felipecacique/MagneticLevitation/Others/arduino com interface grafica utilizando processing.docx

Estive trabalhando hoje na interface gráfica do arduino utilizando o processing, e eis os resultados que obtive: as curvas são valores de tensão lidas na entrada analógica do arduino

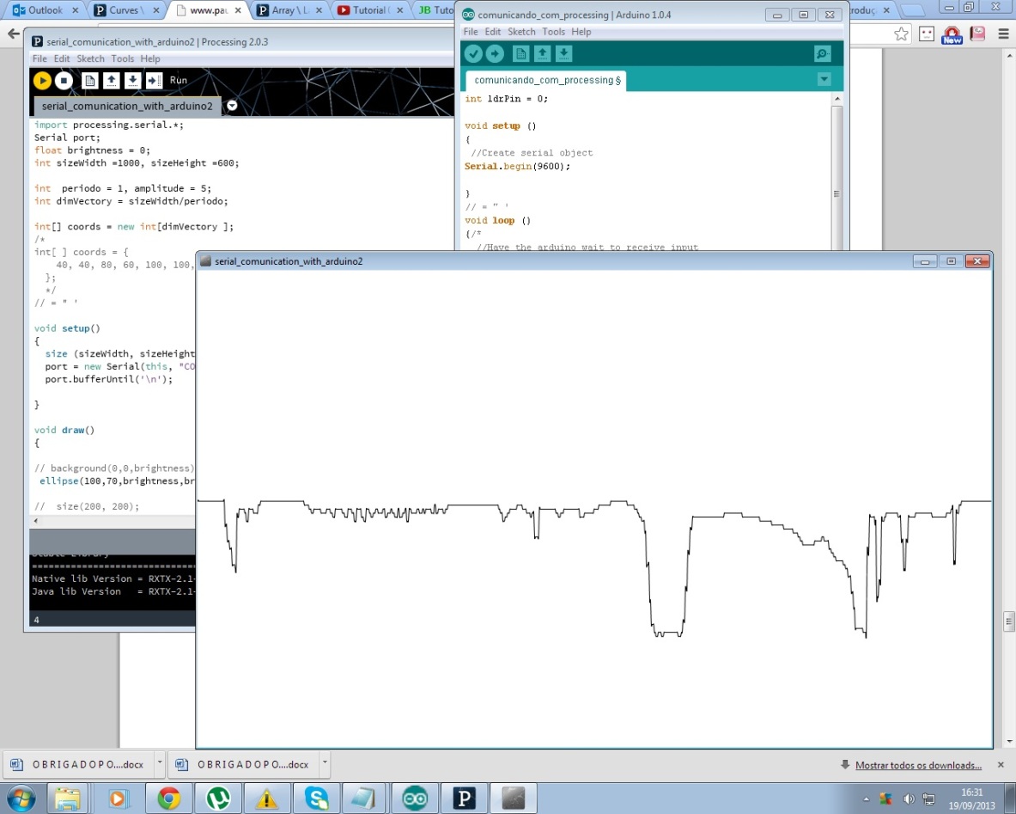
[picture p8: figure]
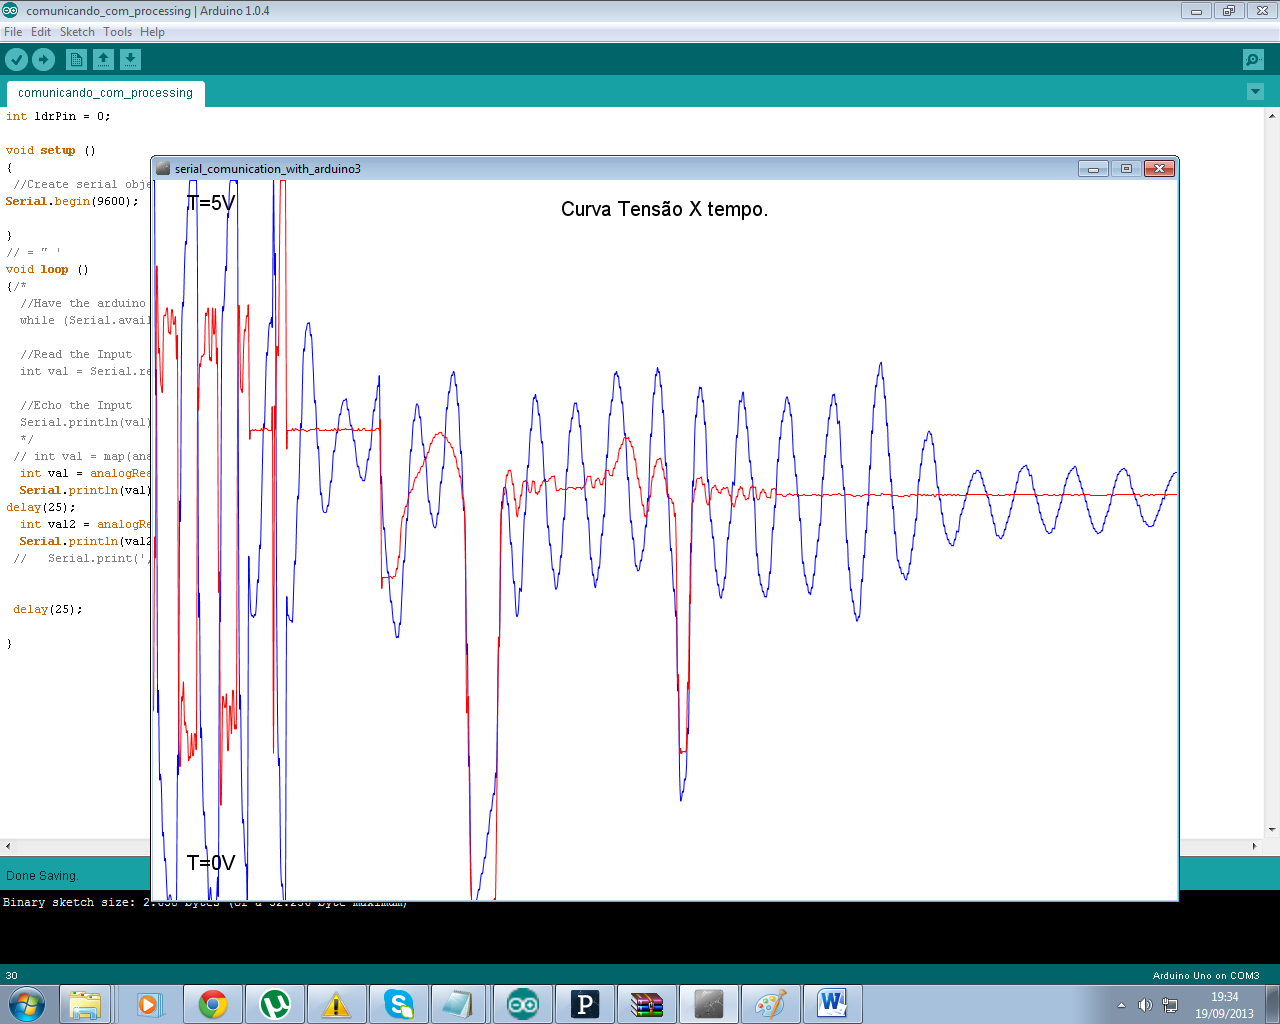
[picture p9: figure]

Leitura simultânea de duas entradas analogicas
