felipecacique/MagneticLevitation/Others/13.png

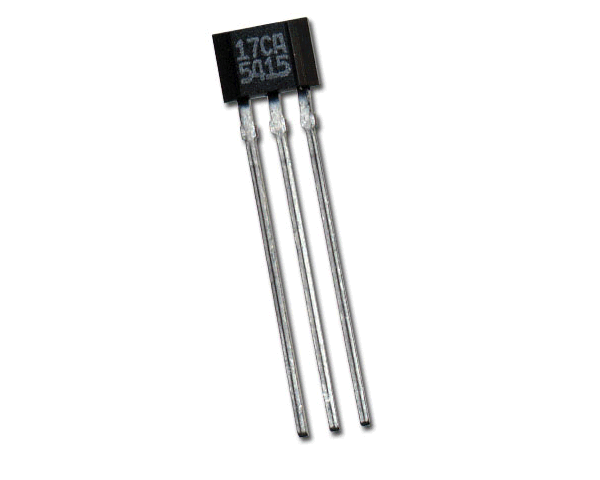
Others/13.png
