felipecacique/MagneticLevitation/Others/21.jpg

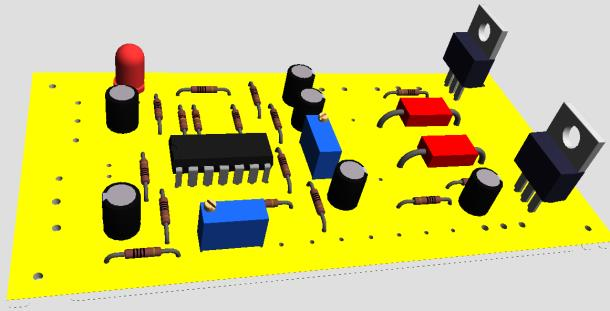
Others/21.jpg
