felipecacique/MagneticLevitation/Others/23.jpg

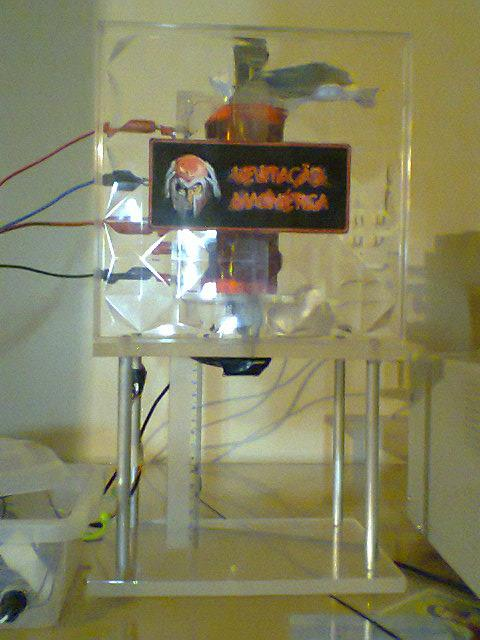
Others/23.jpg
