felipecacique/MagneticLevitation/Others/amplificando sinal com ao.jpg

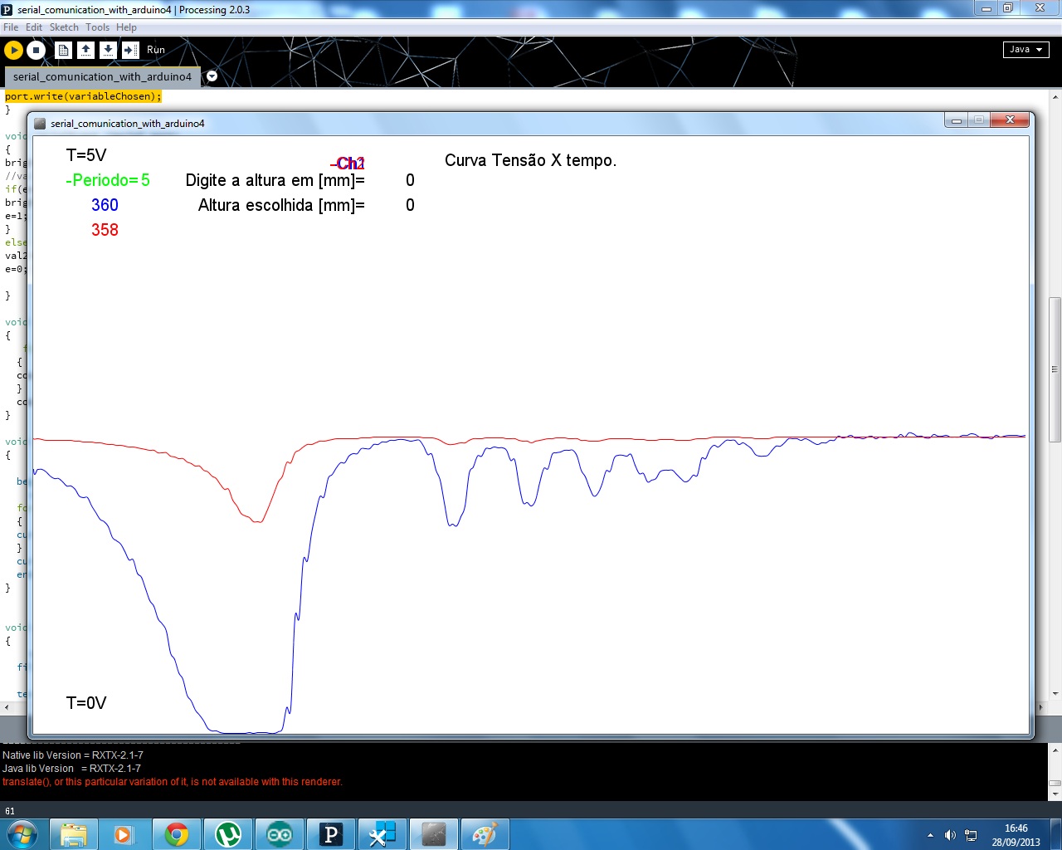
Others/amplificando sinal com ao.jpg
