felipecacique/MagneticLevitation/Others/ard mais process.png

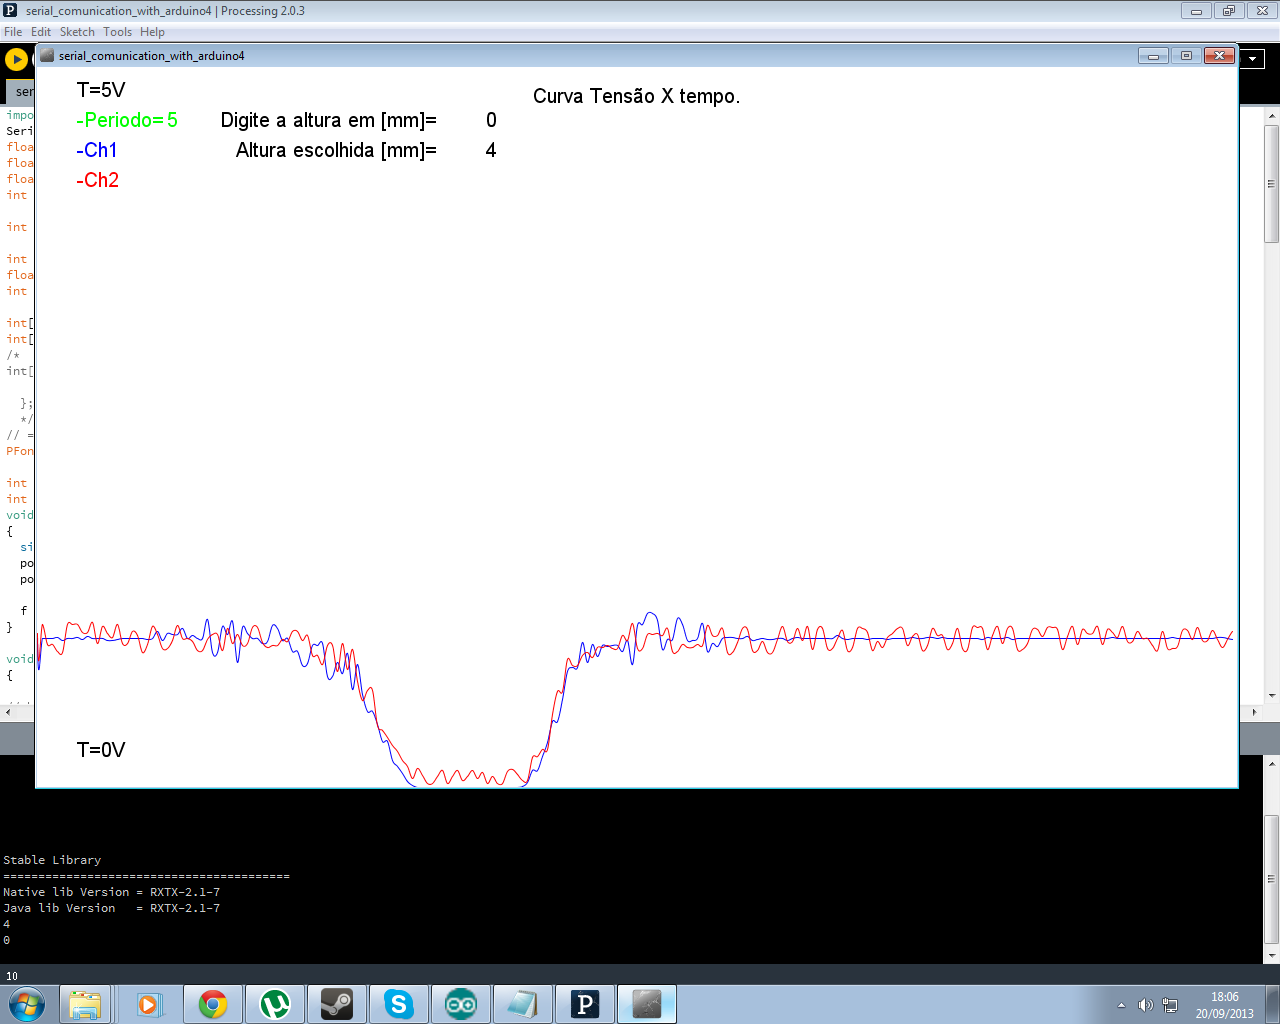
Others/ard mais process.png
