felipecacique/MagneticLevitation/Others/CONDICIONAMENTO DE SINAL.png

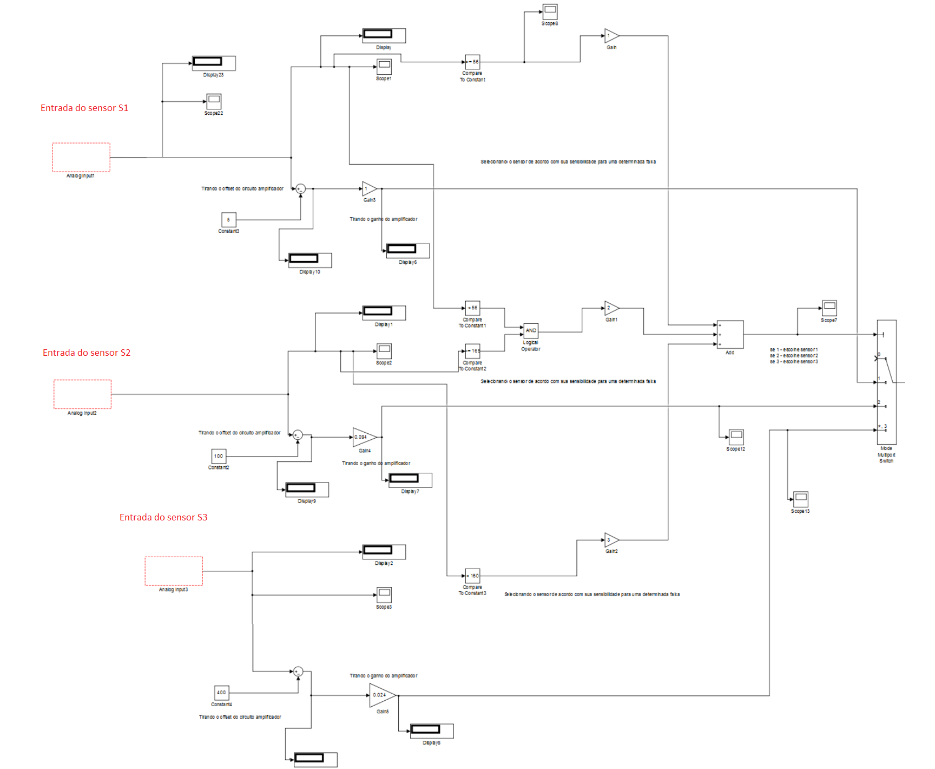
Others/CONDICIONAMENTO DE SINAL.png
