felipecacique/MagneticLevitation/Others/conversao do sensor em posicao.png

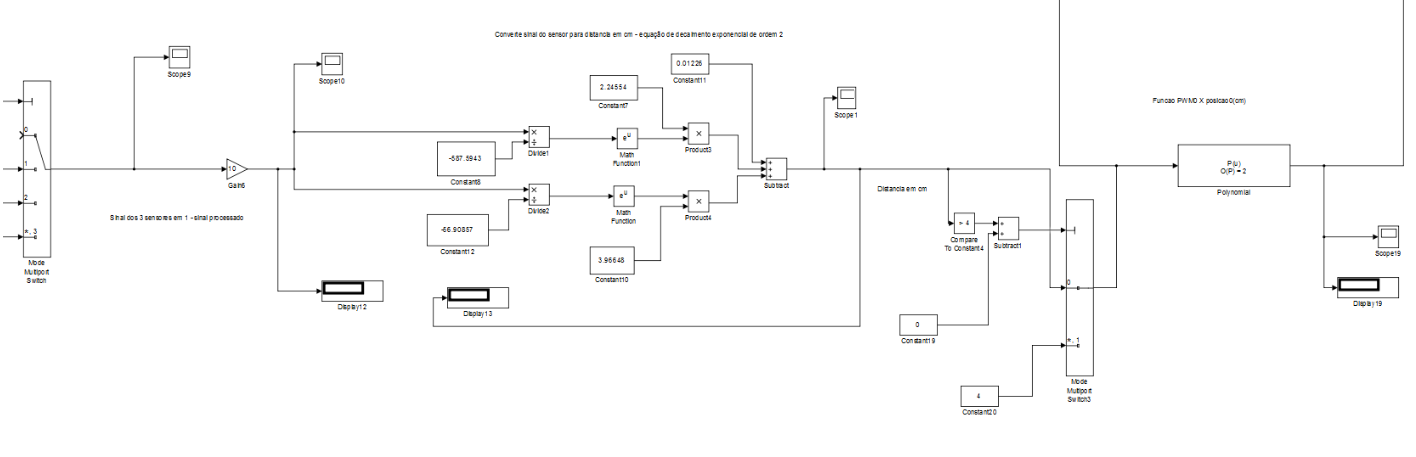
Others/conversao do sensor em posicao.png
