felipecacique/MagneticLevitation/Others/curva tensao x tempo real time.jpg

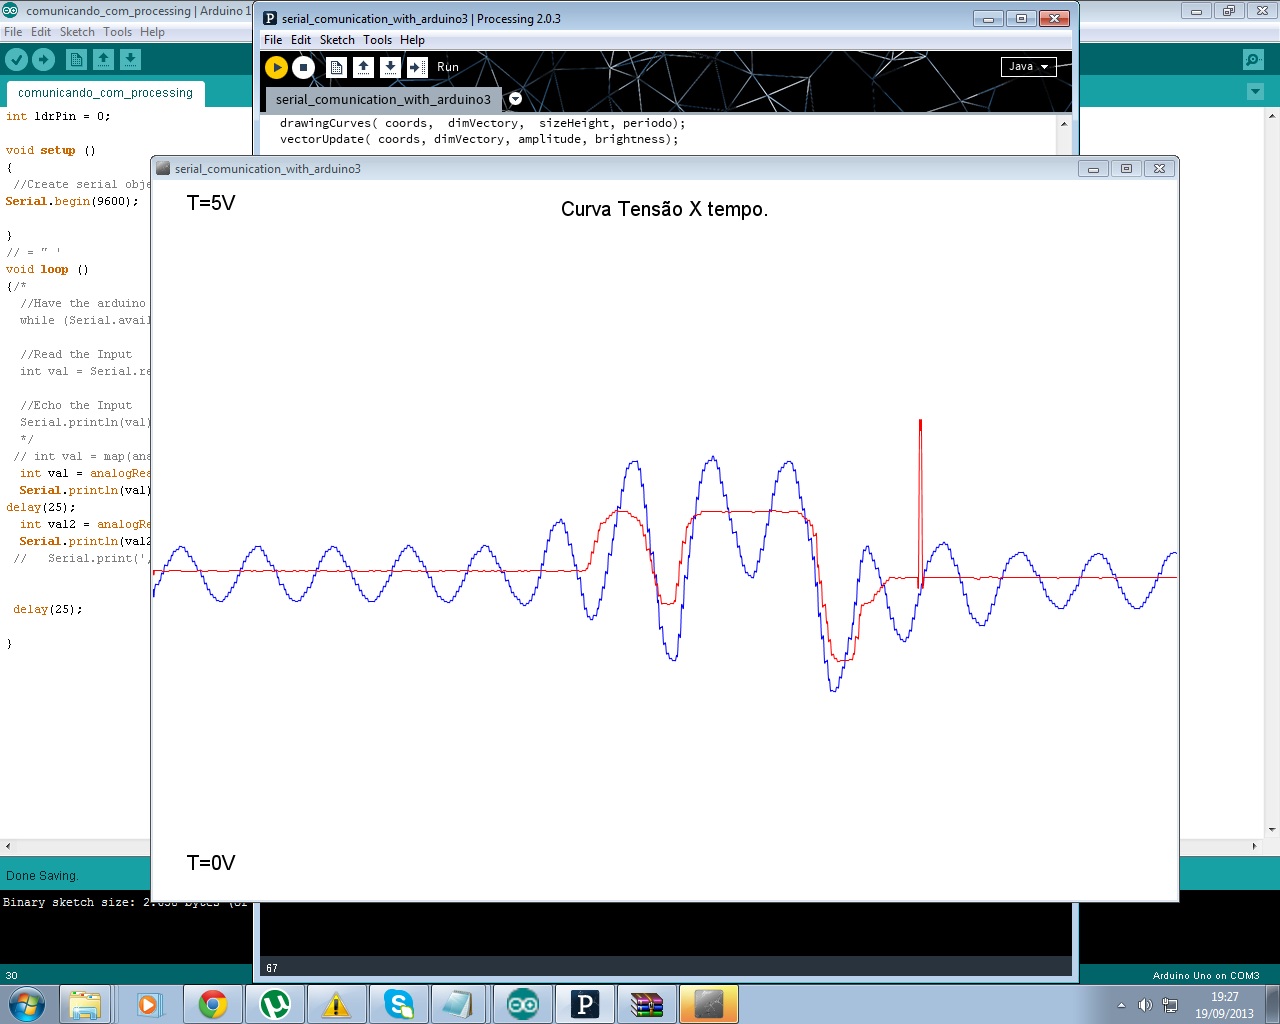
Others/curva tensao x tempo real time.jpg
