felipecacique/MagneticLevitation/Others/malha de controle.png

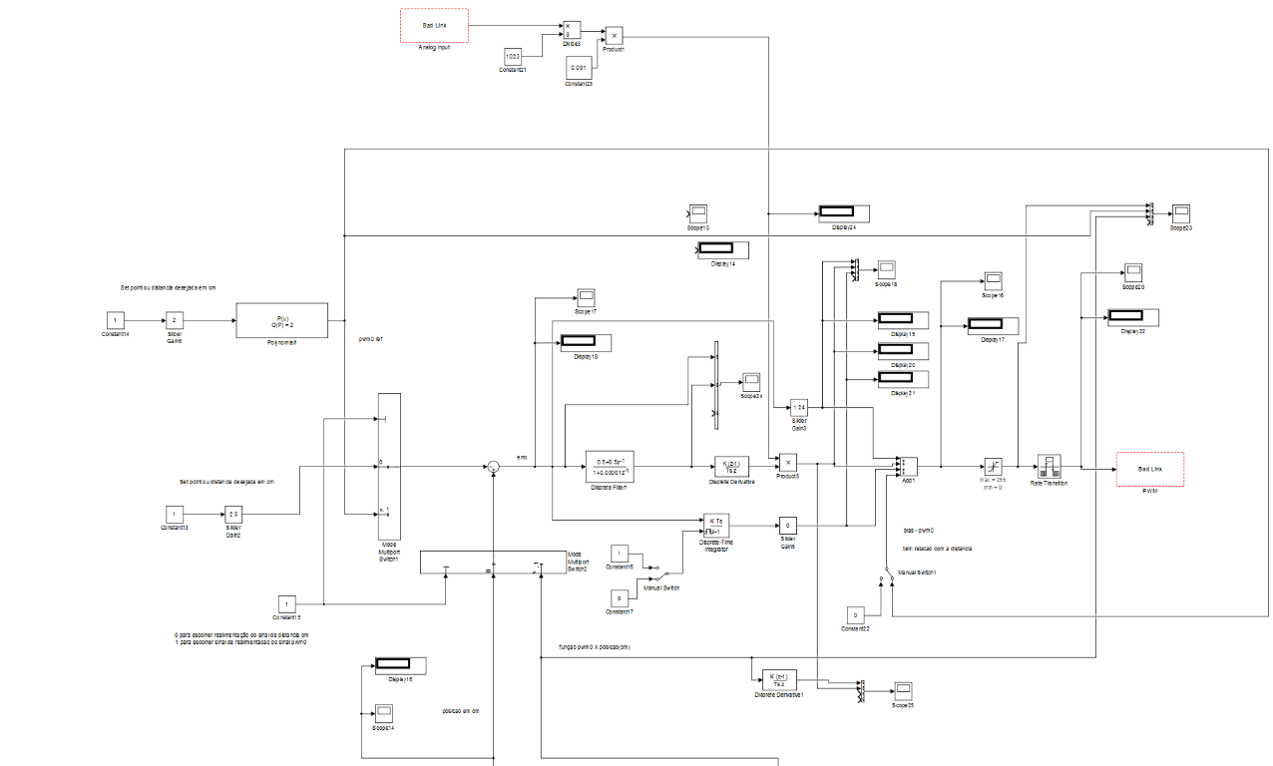
Others/malha de controle.png
