felipecacique/MagneticLevitation/Others/monragem1.JPG

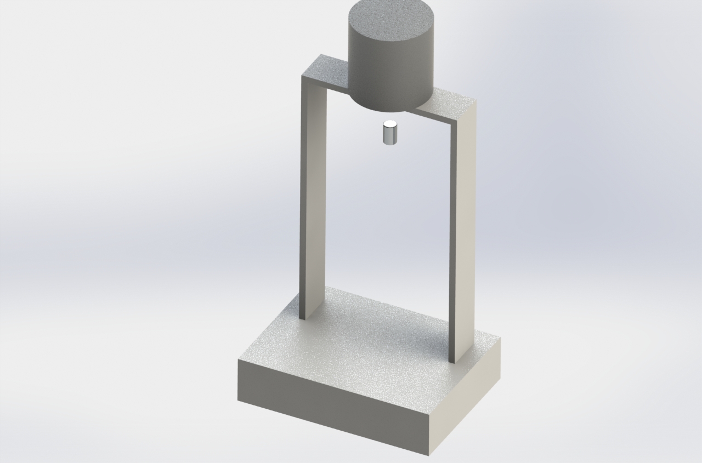
Others/monragem1.JPG
