felipecacique/MagneticLevitation/Others/pcb 3d.png

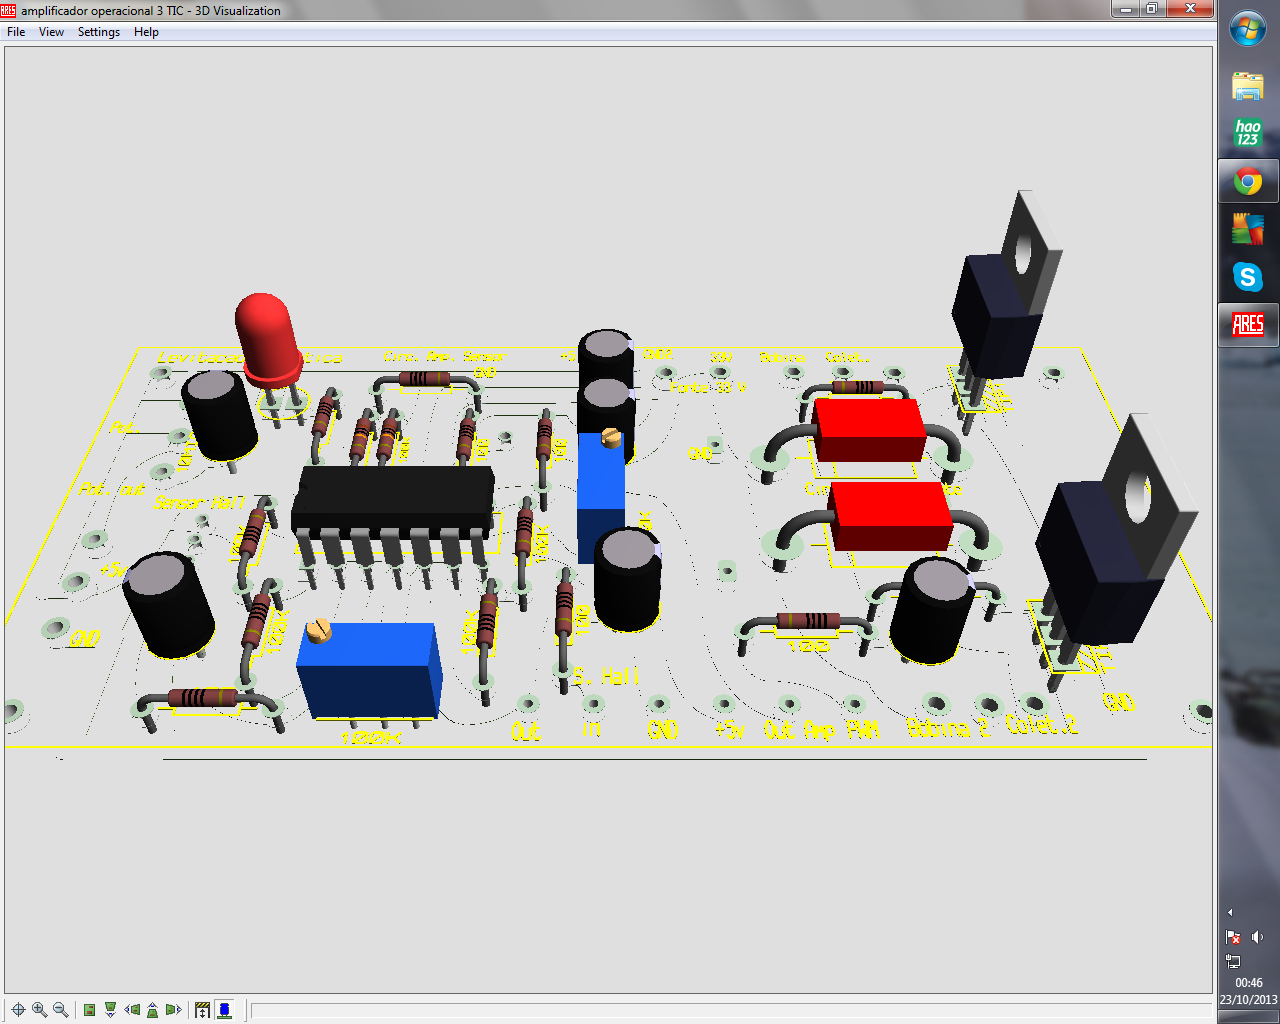
Others/pcb 3d.png
