felipecacique/MagneticLevitation/Others/pcb.png

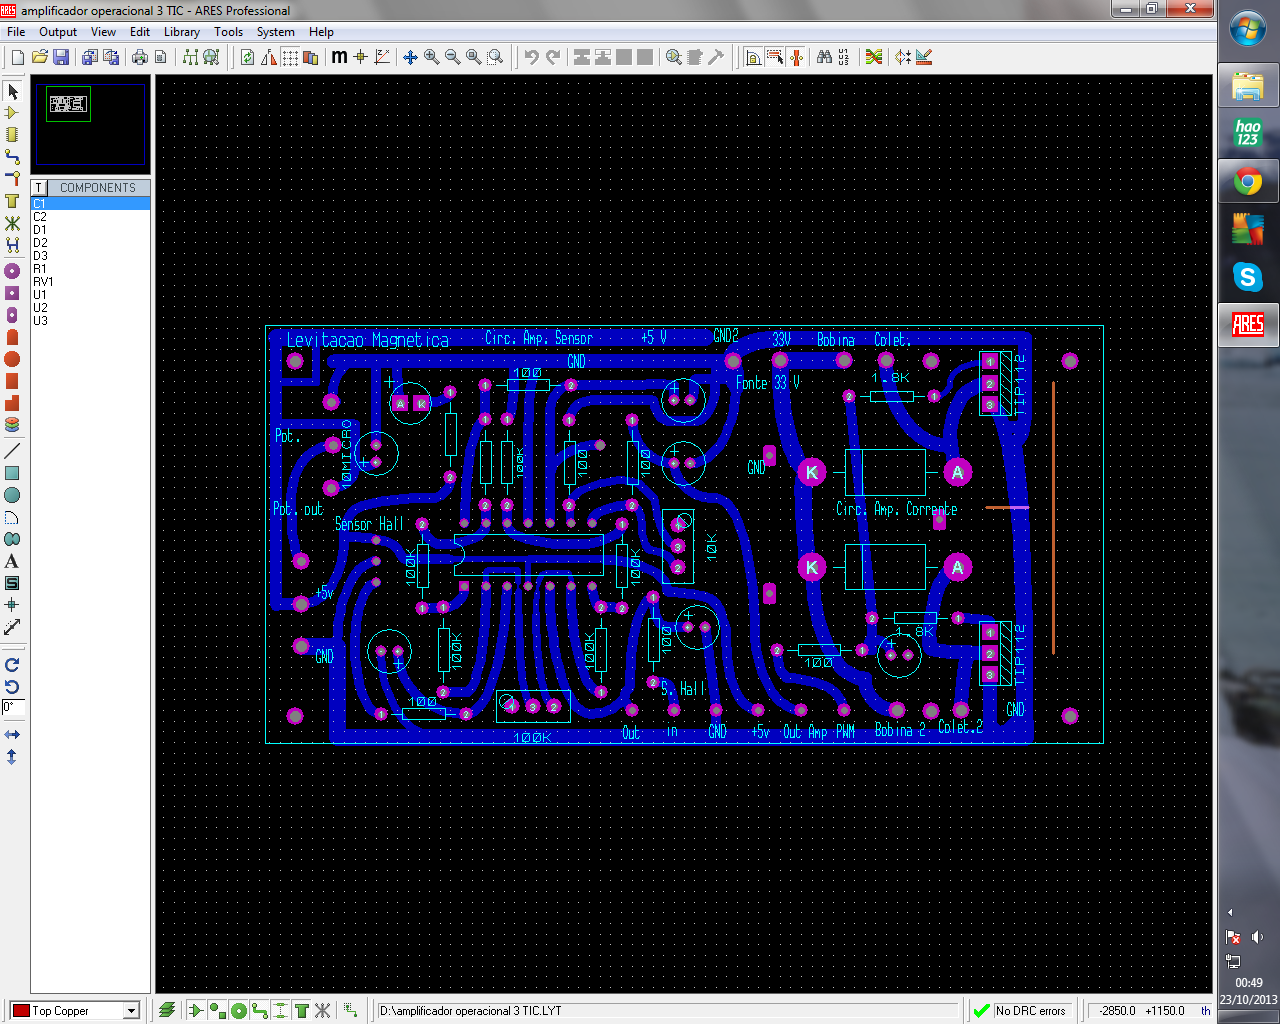
Others/pcb.png
