felipecacique/MagneticLevitation/Others/posiçaoxsensor.png

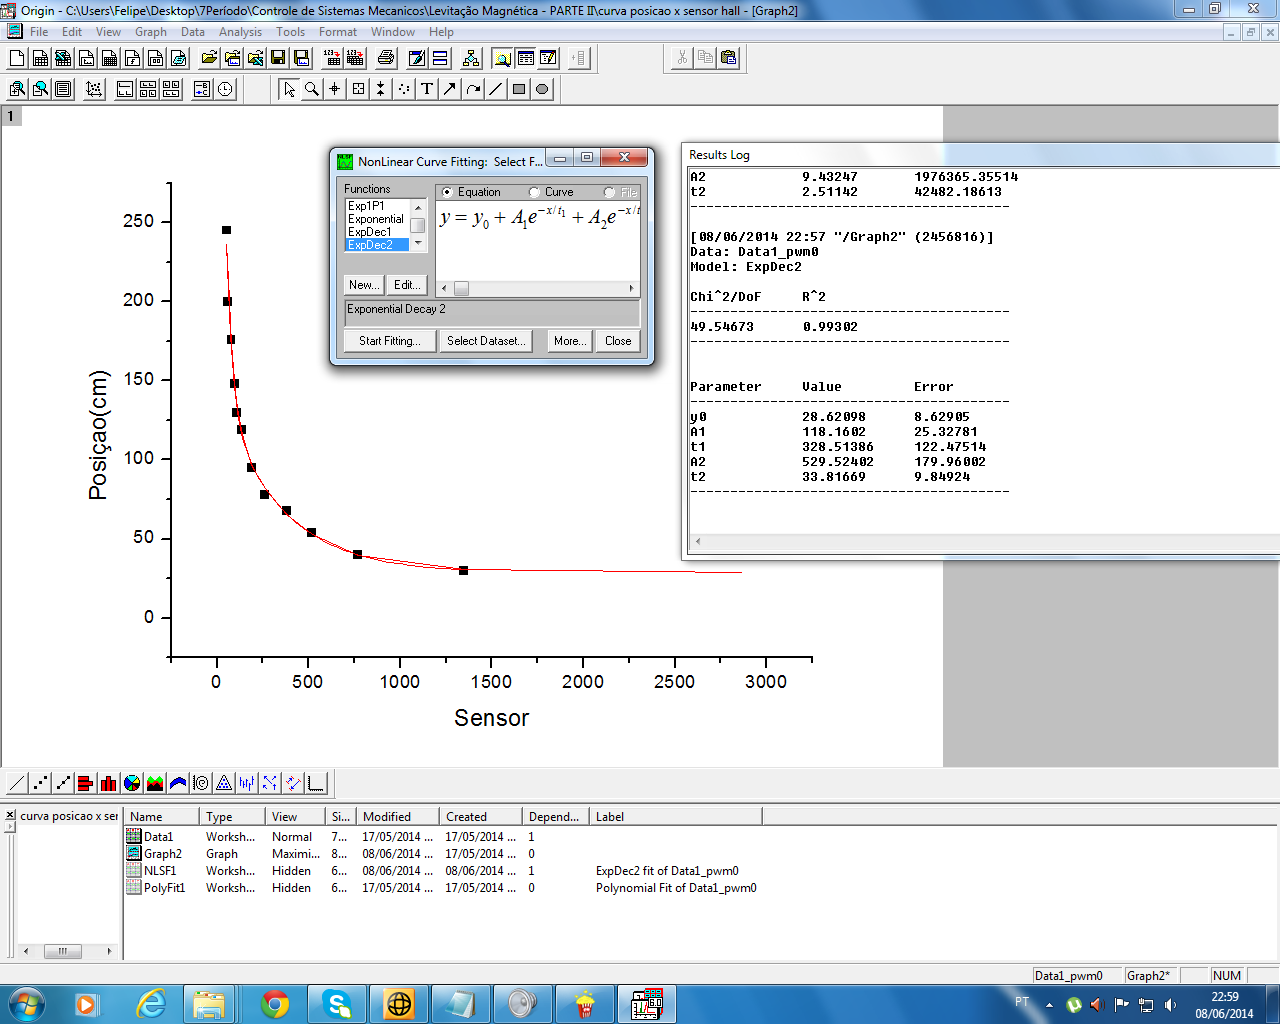
Others/posiçaoxsensor.png
