felipecacique/MagneticLevitation/Others/Sem título.png

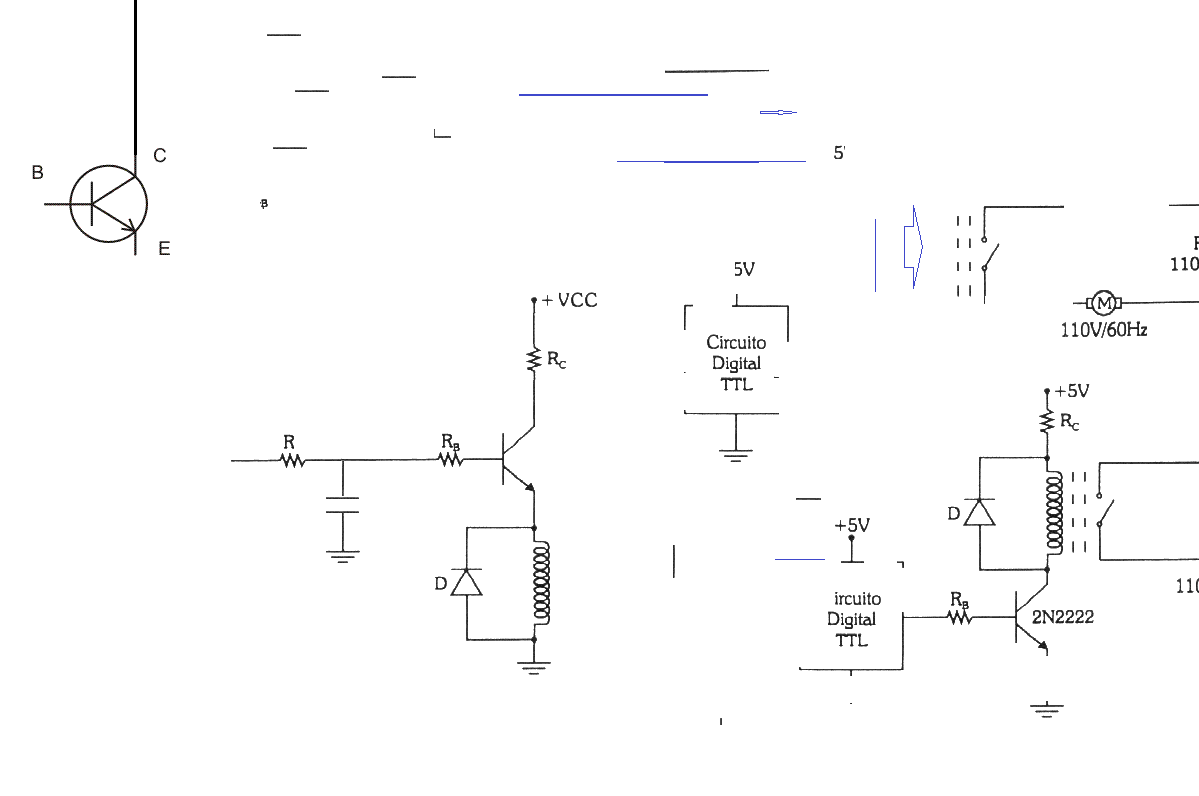
Others/Sem título.png
