felipecacique/MagneticLevitation/Others/serial comunication processing and arduino2.jpg

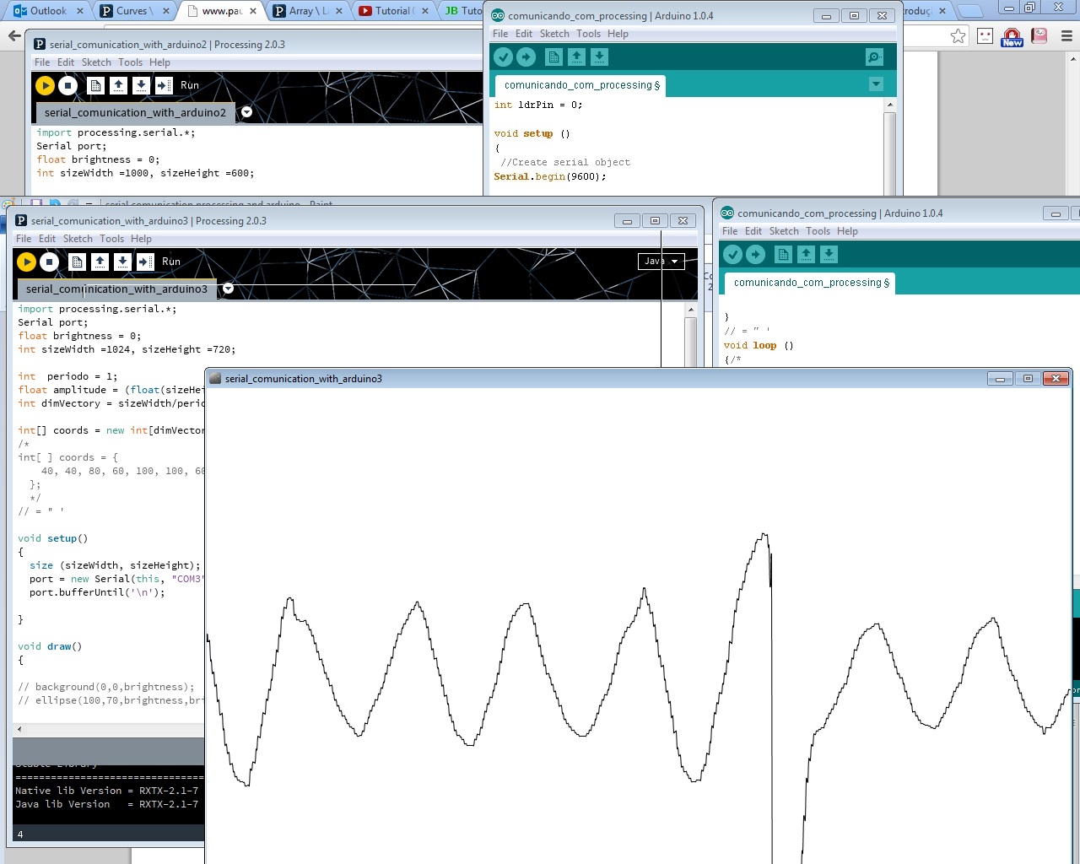
Others/serial comunication processing and arduino2.jpg
