felipecacique/MagneticLevitation/Making Off/A day in the lab/20131029_141220.jpg

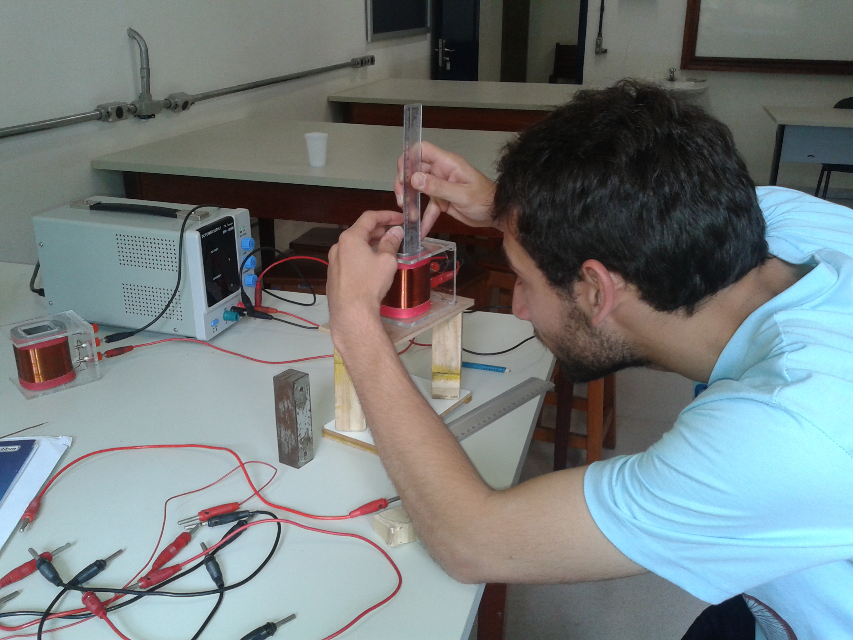
Making Off/A day in the lab/20131029_141220.jpg
