felipecacique/MagneticLevitation/Making Off/A day in the lab/20131029_142736.jpg

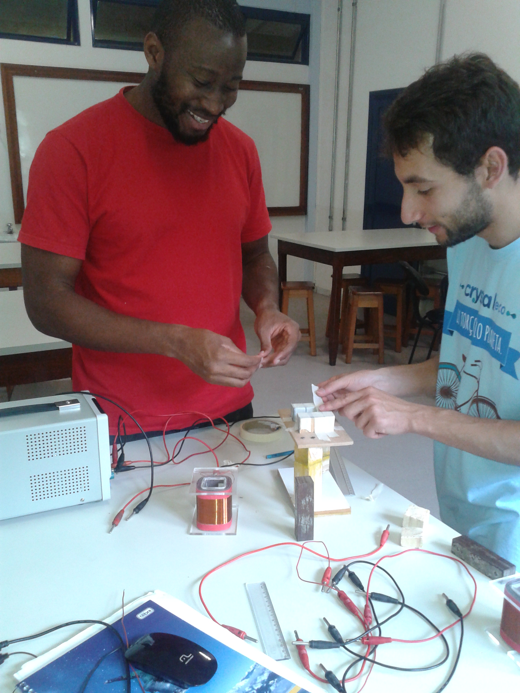
Making Off/A day in the lab/20131029_142736.jpg
