felipecacique/MagneticLevitation/Making Off/A day in the lab/20131029_150129.jpg

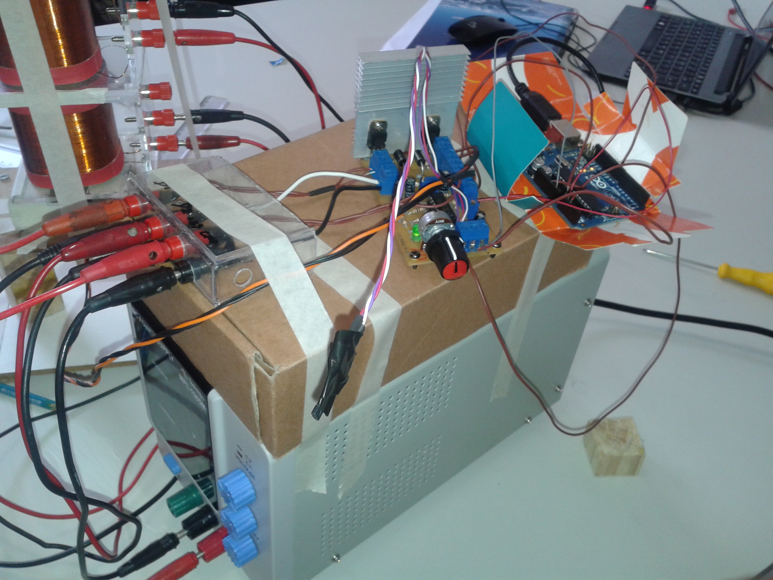
Making Off/A day in the lab/20131029_150129.jpg
