felipecacique/MagneticLevitation/Making Off/A day in the lab/20131105_181018.jpg

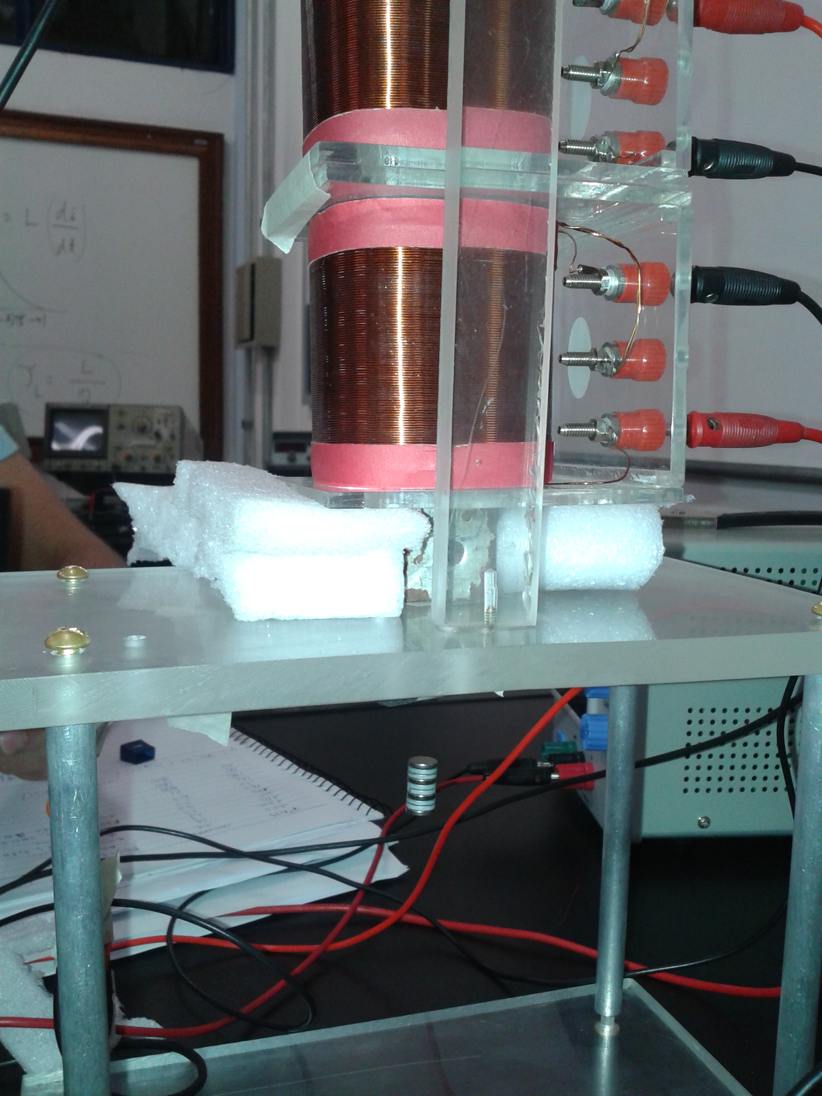
Making Off/A day in the lab/20131105_181018.jpg
