felipecacique/MagneticLevitation/Making Off/A day in the lab/20131105_181040.jpg

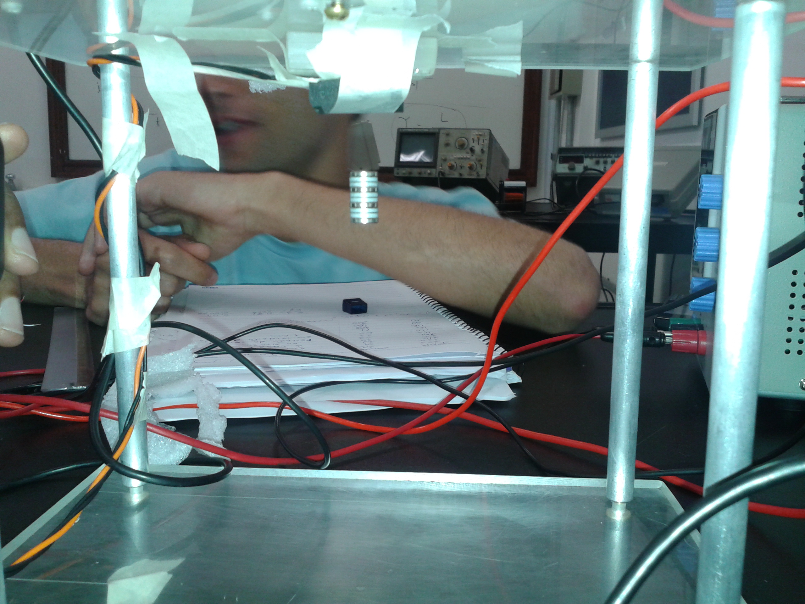
Making Off/A day in the lab/20131105_181040.jpg
