felipecacique/MagneticLevitation/Making Off/A day in the lab/20131105_181154.jpg

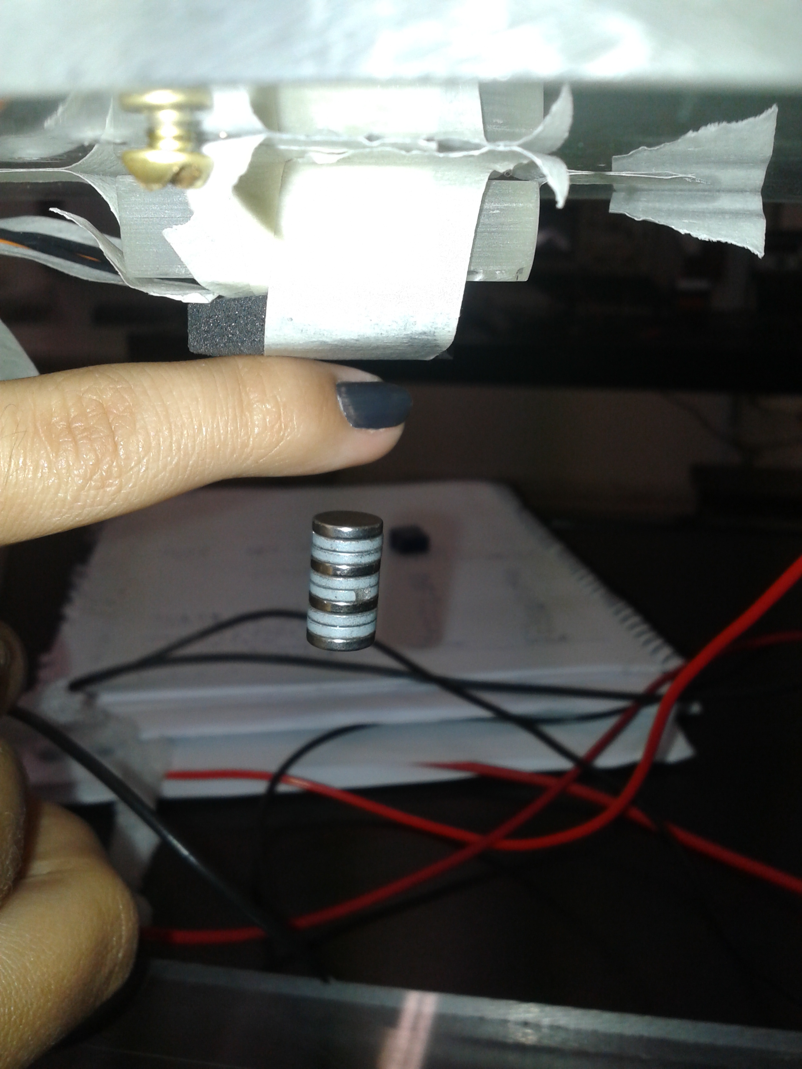
Making Off/A day in the lab/20131105_181154.jpg
