felipecacique/MagneticLevitation/Making Off/First propotype/Foto1720.jpg

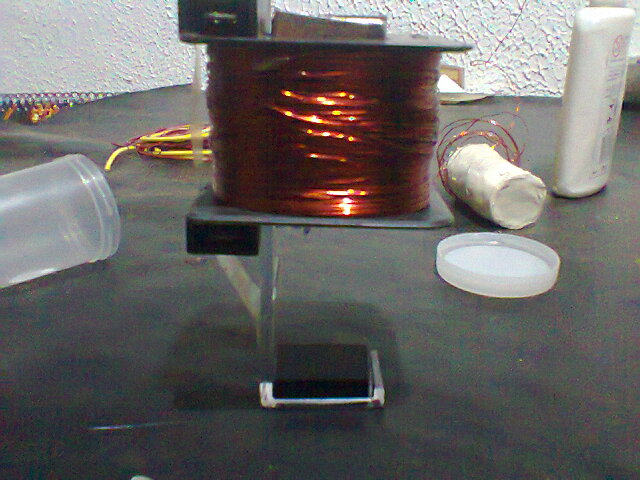
Making Off/First propotype/Foto1720.jpg
