felipecacique/MagneticLevitation/Making Off/First propotype/Foto1721.jpg

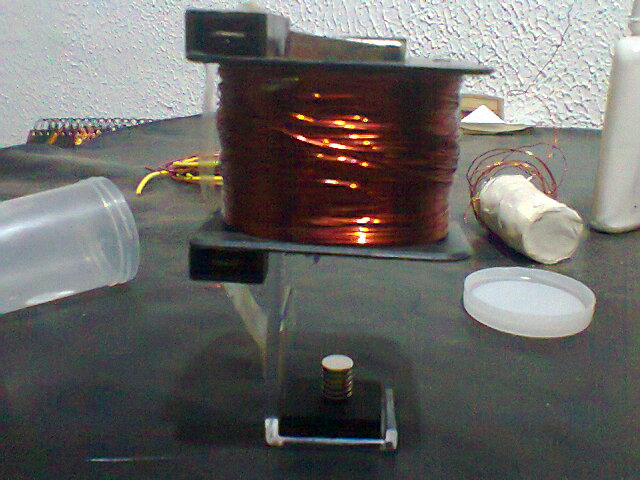
Making Off/First propotype/Foto1721.jpg
