felipecacique/MagneticLevitation/Making Off/First propotype/Foto1722.jpg

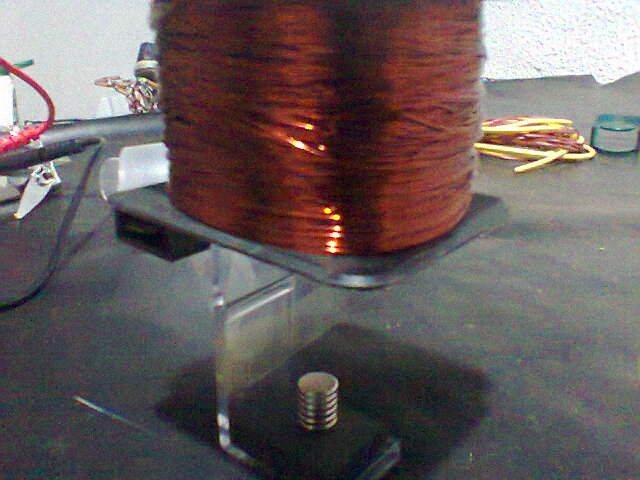
Making Off/First propotype/Foto1722.jpg
