felipecacique/MagneticLevitation/Making Off/First propotype/Foto1723.jpg

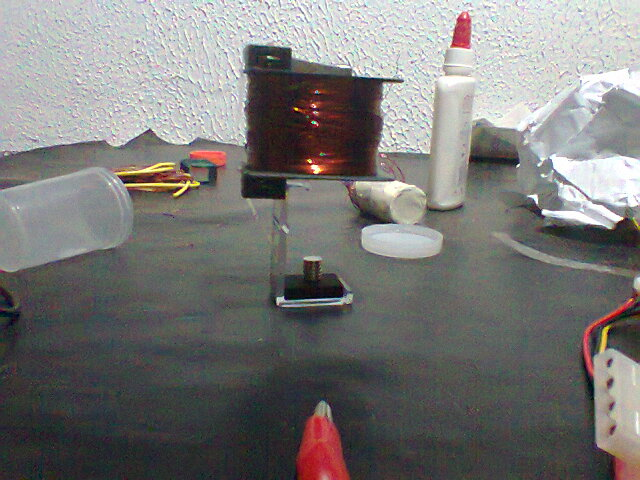
Making Off/First propotype/Foto1723.jpg
