felipecacique/MagneticLevitation/Making Off/Presentation at PucMinas/945462_259994994147607_562854538_n.jpg

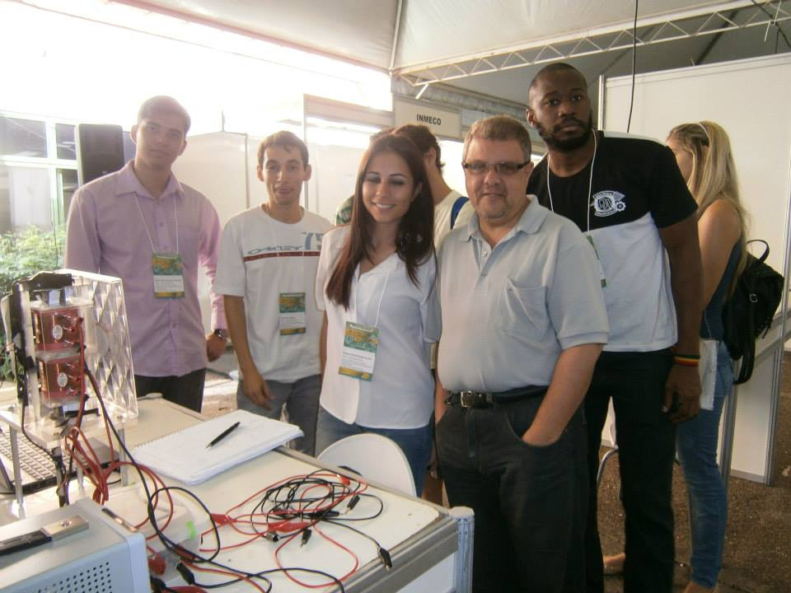
Making Off/Presentation at PucMinas/945462_259994994147607_562854538_n.jpg
