felipecacique/MagneticLevitation/Making Off/Presentation at PucMinas/1003881_259994787480961_912195179_n.jpg

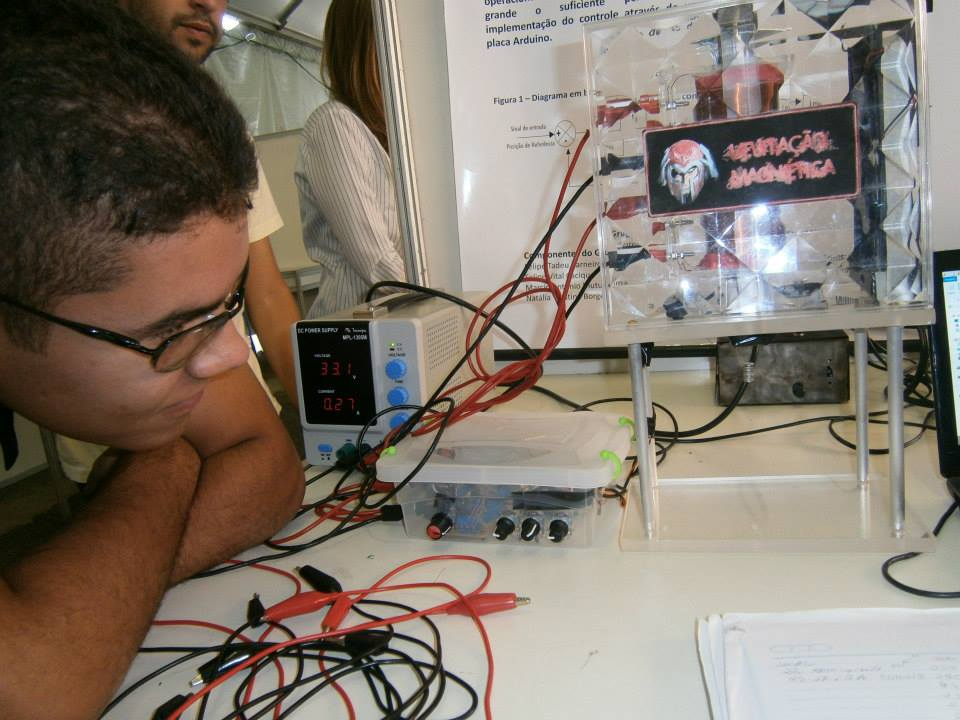
Making Off/Presentation at PucMinas/1003881_259994787480961_912195179_n.jpg
