felipecacique/MagneticLevitation/Making Off/Presentation at PucMinas/20131113_081703.jpg

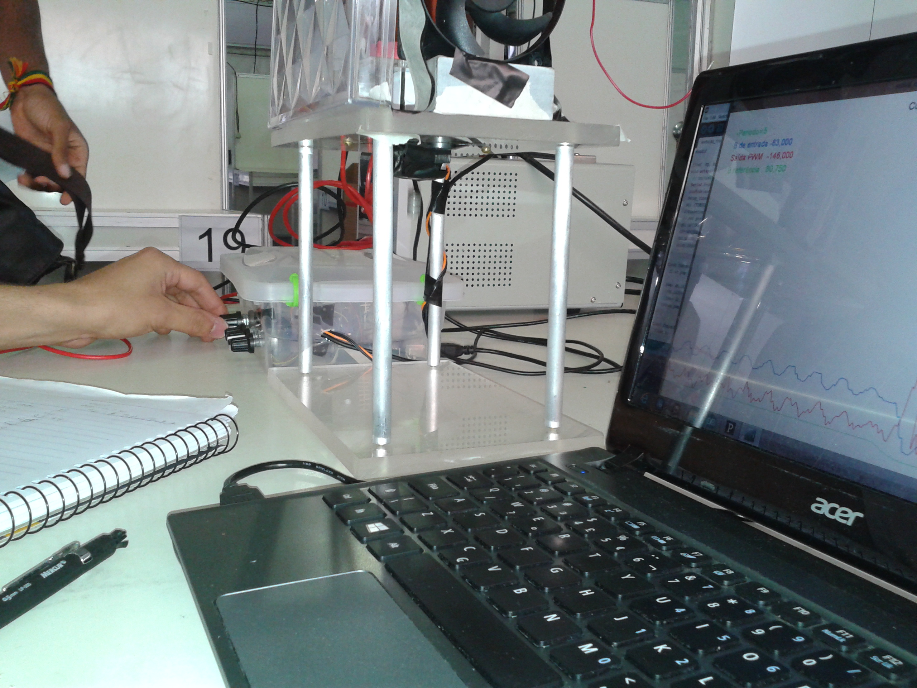
Making Off/Presentation at PucMinas/20131113_081703.jpg
