felipecacique/MagneticLevitation/Making Off/Presentation at PucMinas/20131113_084432.jpg

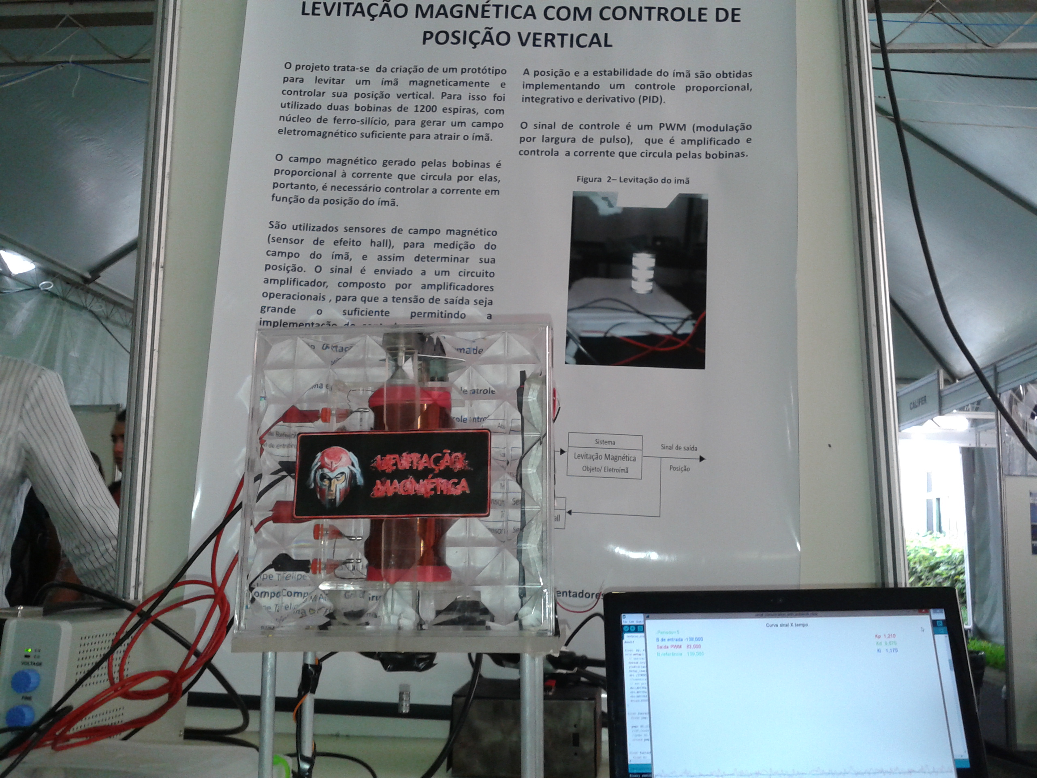
Making Off/Presentation at PucMinas/20131113_084432.jpg
