felipecacique/MagneticLevitation/Making Off/Presentation at PucMinas/20131113_092832.jpg

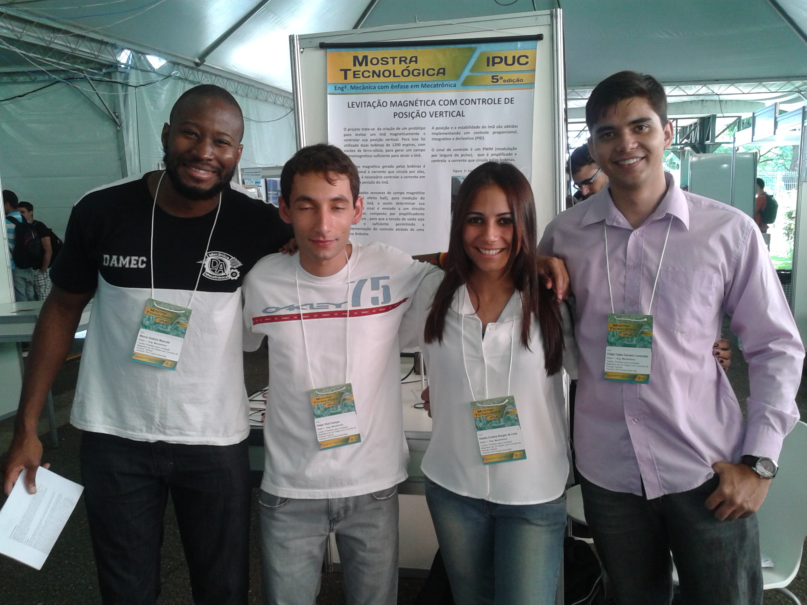
Making Off/Presentation at PucMinas/20131113_092832.jpg
