felipecacique/MagneticLevitation/Making Off/Presentation at PucMinas/20131113_092847.jpg

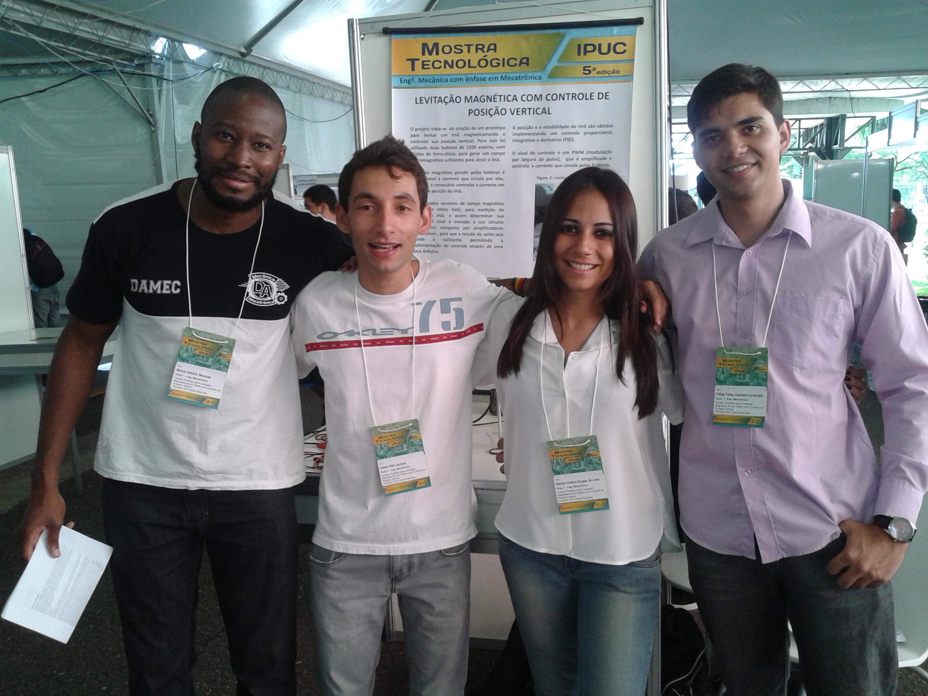
Making Off/Presentation at PucMinas/20131113_092847.jpg
