felipecacique/MagneticLevitation/Making Off/Presentation at PucMinas/20131113_092908.jpg

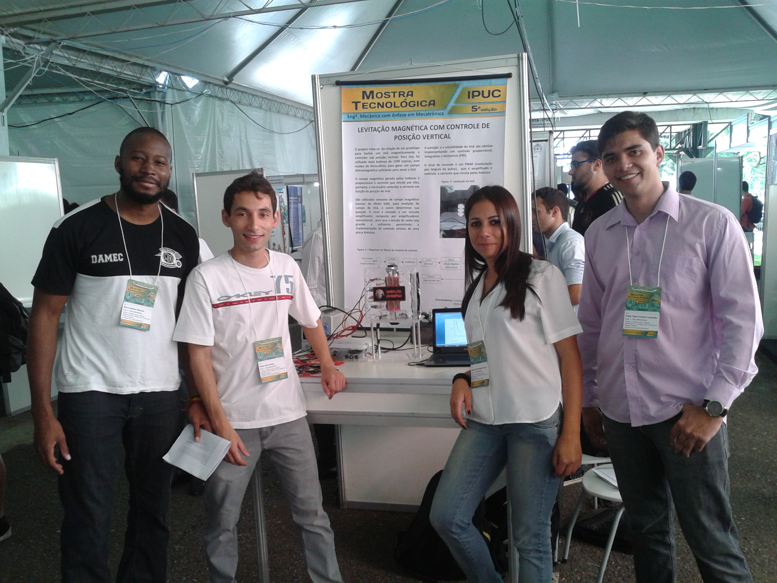
Making Off/Presentation at PucMinas/20131113_092908.jpg
