felipecacique/MagneticLevitation/Making Off/Presentation at PucMinas/20131113_101631.jpg

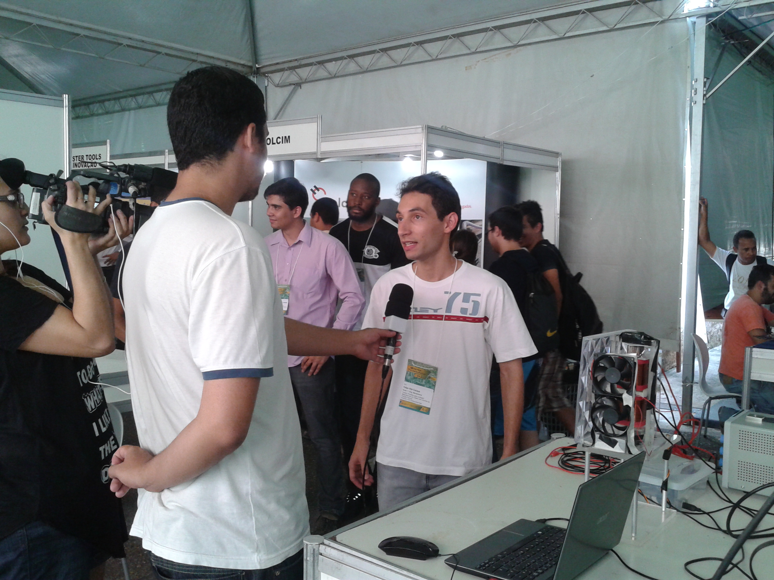
Making Off/Presentation at PucMinas/20131113_101631.jpg
