felipecacique/MagneticLevitation/Making Off/Presentation at PucMinas/20131113_113805.jpg

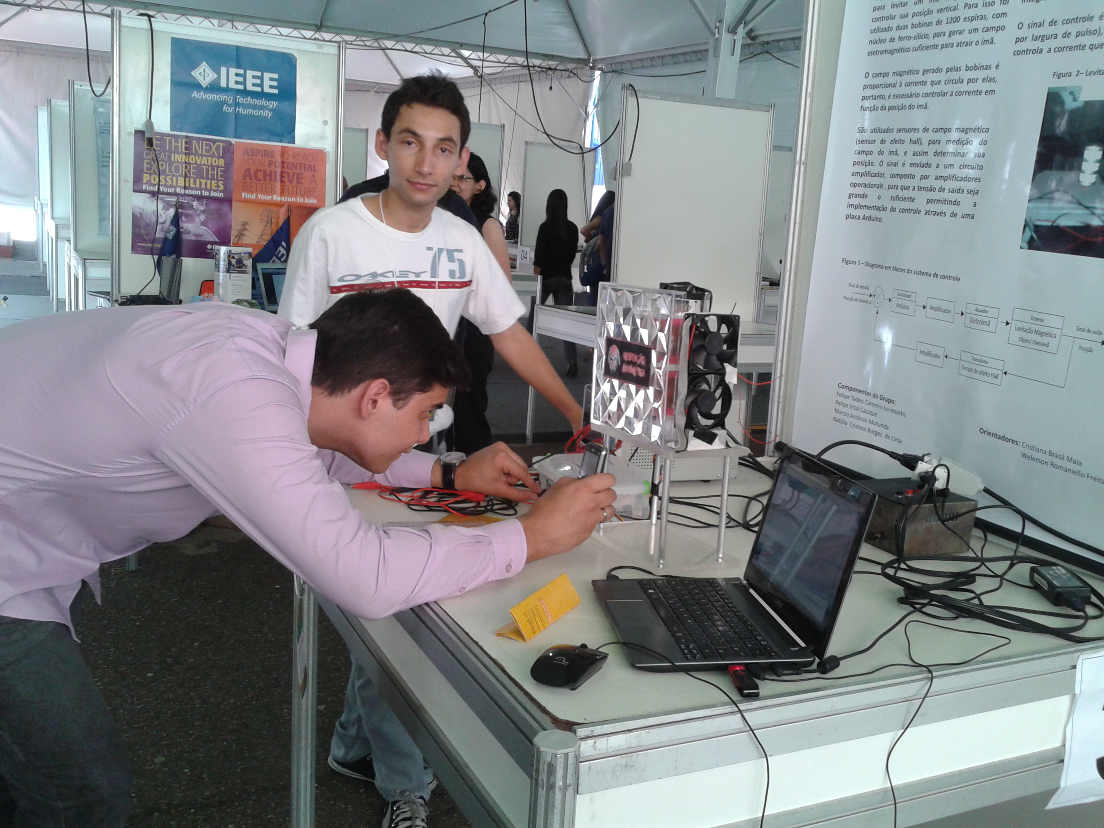
Making Off/Presentation at PucMinas/20131113_113805.jpg
