felipecacique/MagneticLevitation/Making Off/Presentation at PucMinas/20131113_113811.jpg

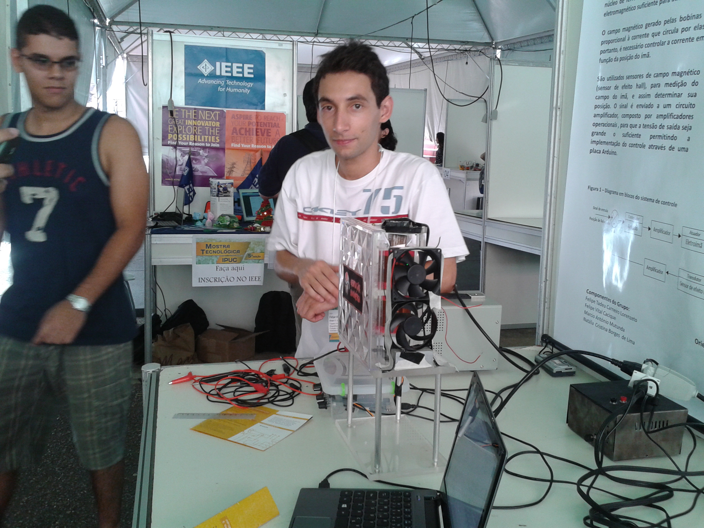
Making Off/Presentation at PucMinas/20131113_113811.jpg
