felipecacique/MagneticLevitation/Making Off/Presentation at PucMinas/20131113_113825.jpg

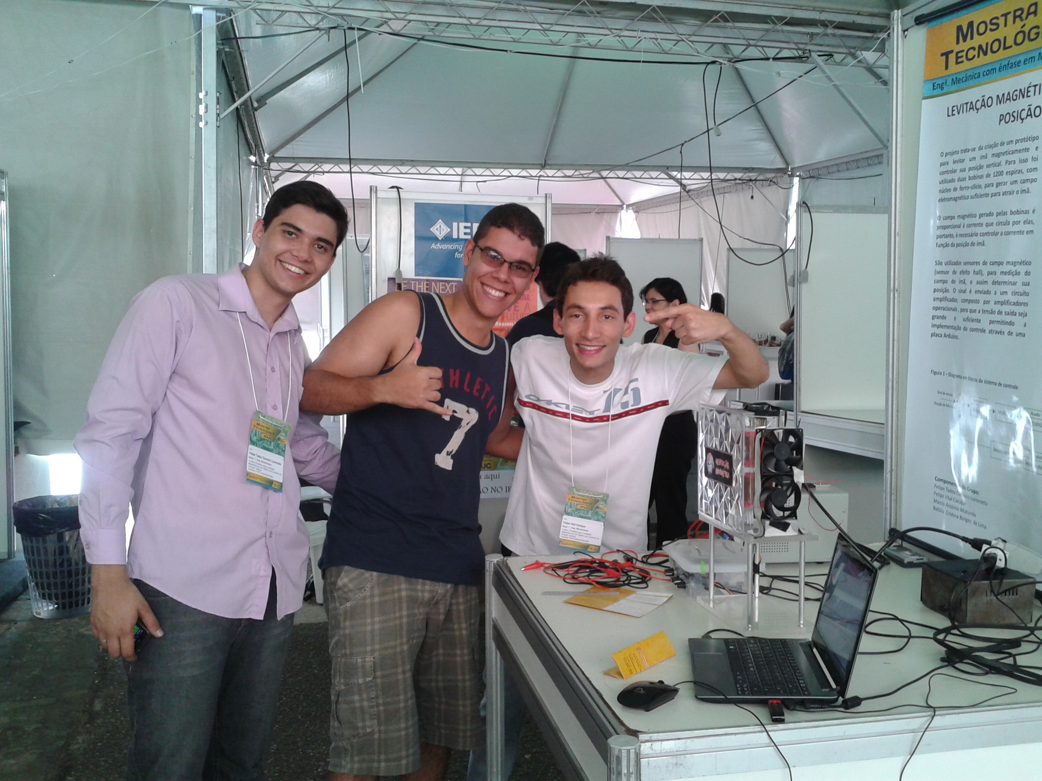
Making Off/Presentation at PucMinas/20131113_113825.jpg
