felipecacique/MagneticLevitation/Making Off/Presentation at PucMinas/20131113_113841.jpg

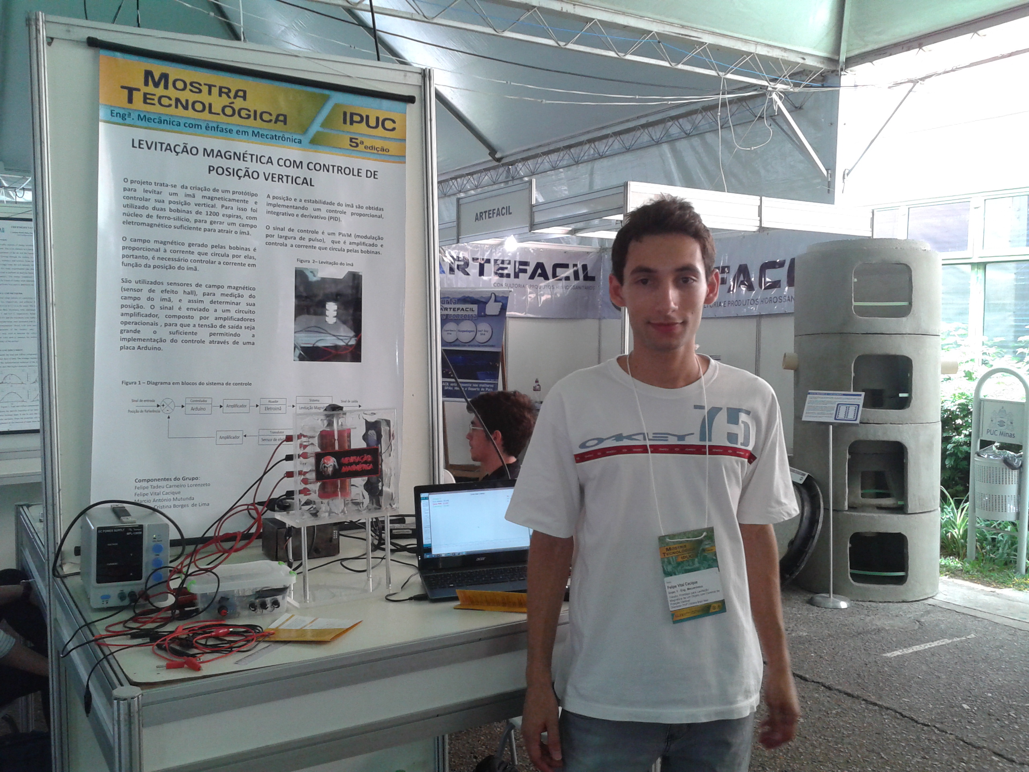
Making Off/Presentation at PucMinas/20131113_113841.jpg
