felipecacique/MagneticLevitation/Making Off/Presentation at PucMinas/20131113_203519.jpg

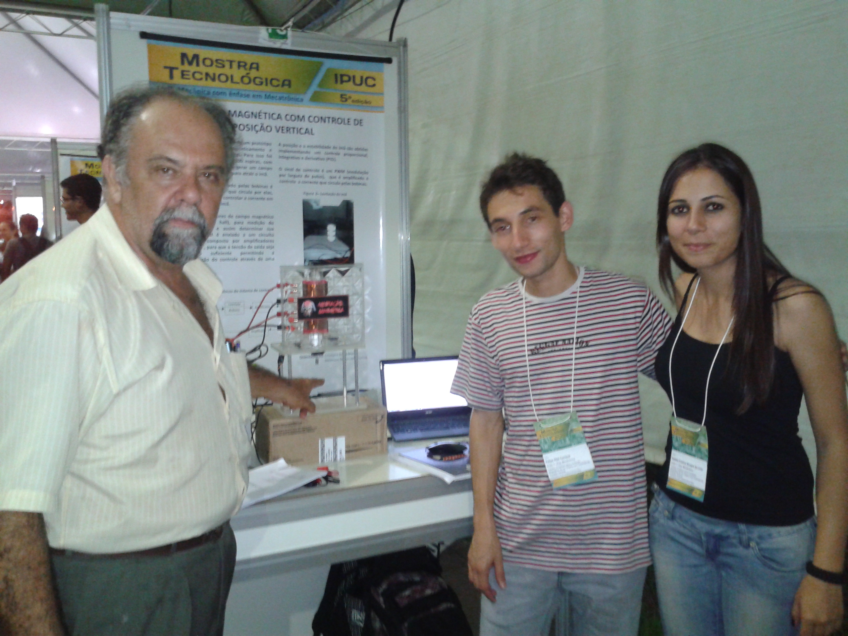
Making Off/Presentation at PucMinas/20131113_203519.jpg
