felipecacique/MagneticLevitation/Making Off/Presentation at PucMinas/20131113_203523.jpg

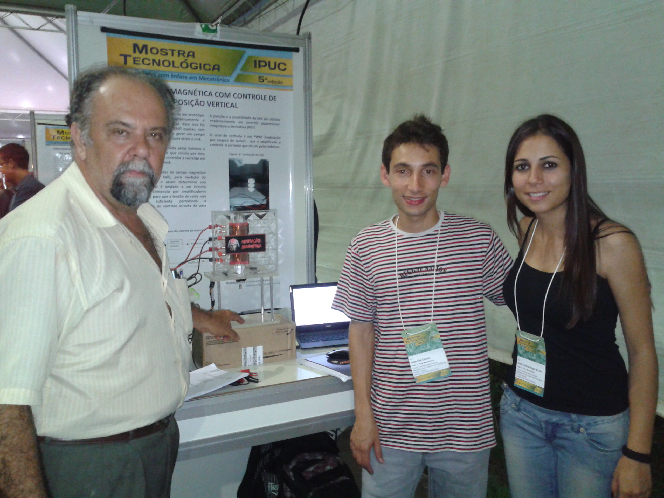
Making Off/Presentation at PucMinas/20131113_203523.jpg
