felipecacique/MagneticLevitation/Making Off/Presentation at PucMinas/20131113_213349.jpg

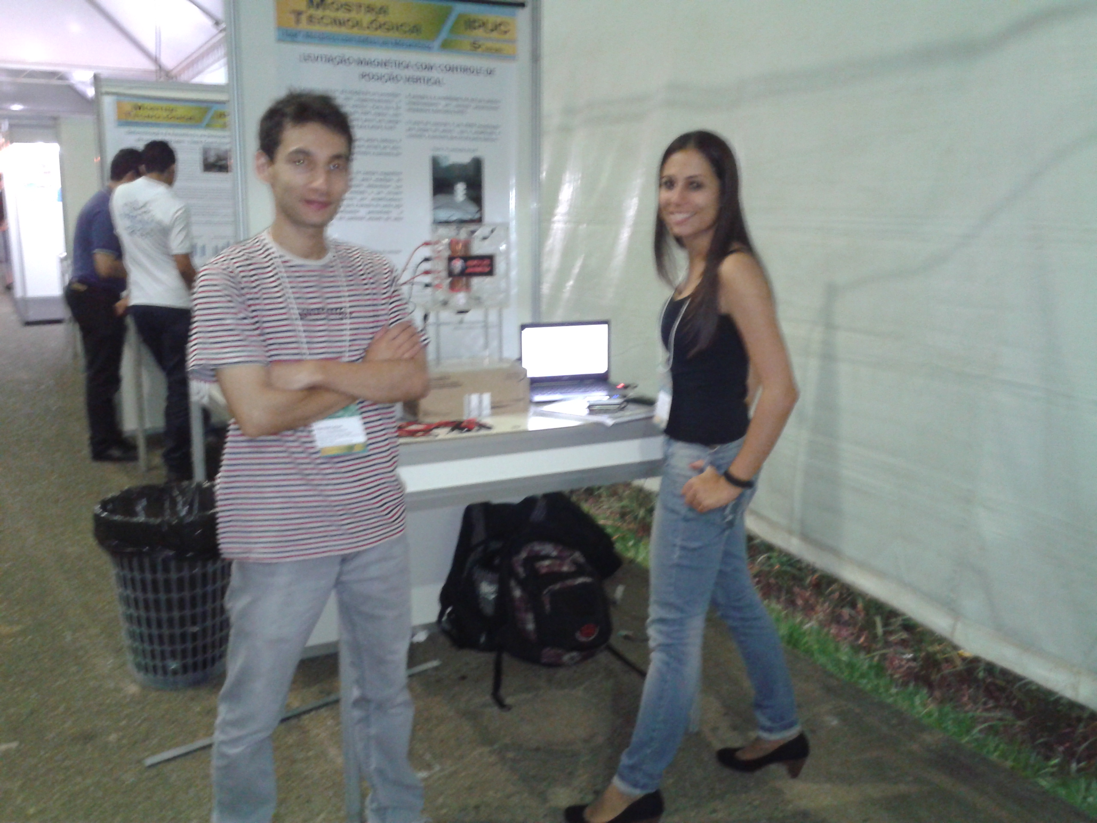
Making Off/Presentation at PucMinas/20131113_213349.jpg
