felipecacique/MagneticLevitation/Others/Levitacao - montagem.png

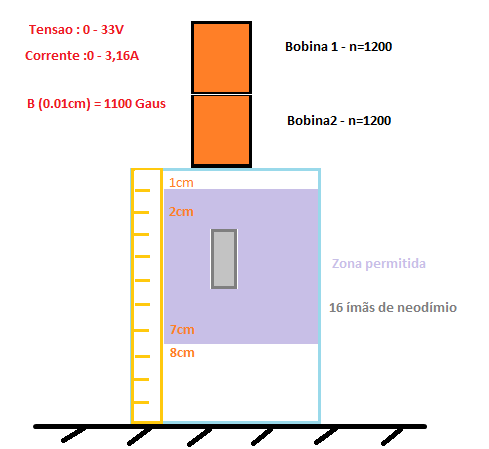
Others/Levitacao - montagem.png
