felipecacique/MagneticLevitation/Magnetic Levitator I/Results/20131113_081840.jpg

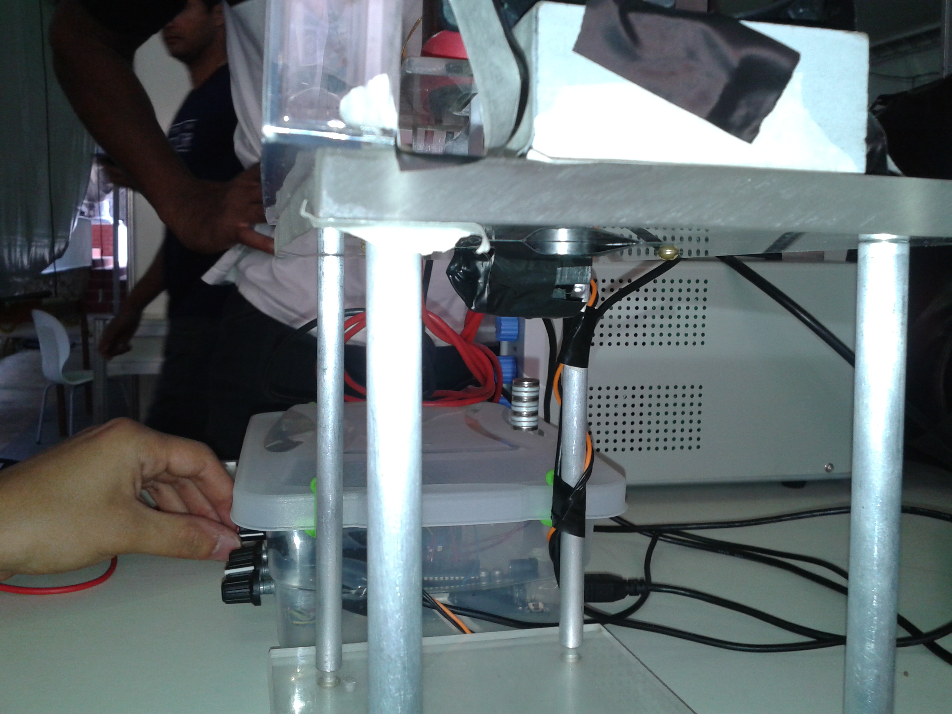
Magnetic Levitator I/Results/20131113_081840.jpg
