felipecacique/MagneticLevitation/Magnetic Levitator I/Results/20131113_213454.jpg

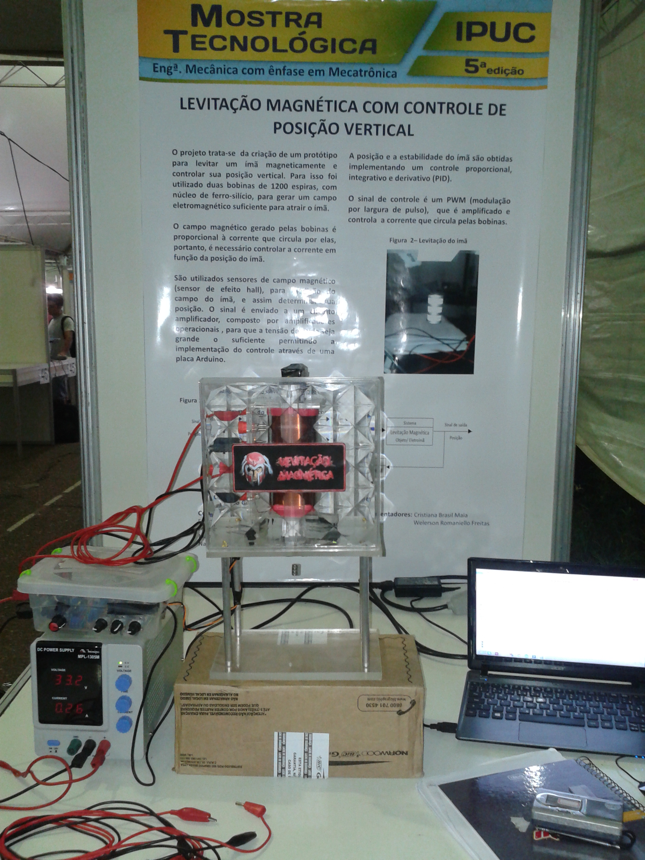
Magnetic Levitator I/Results/20131113_213454.jpg
