felipecacique/MagneticLevitation/Magnetic Levitator II/Results/1.JPG

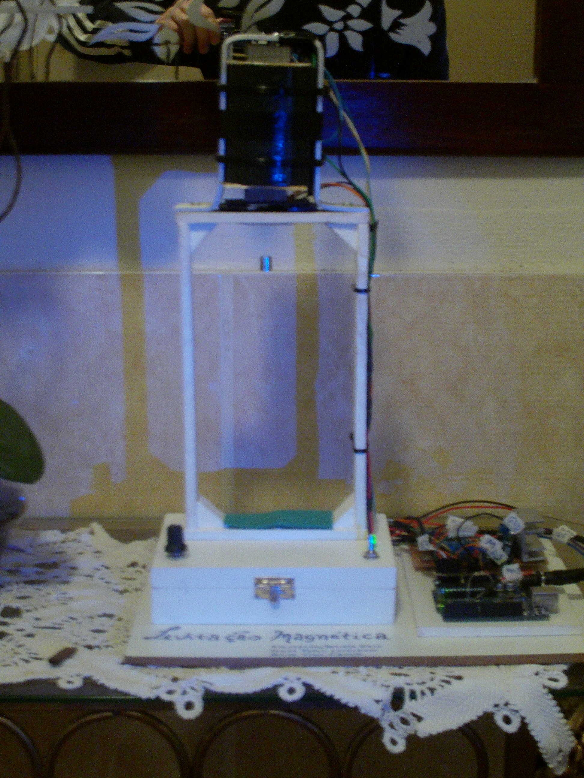
Magnetic Levitator II/Results/1.JPG
