felipecacique/MagneticLevitation/Magnetic Levitator II/Results/2.JPG

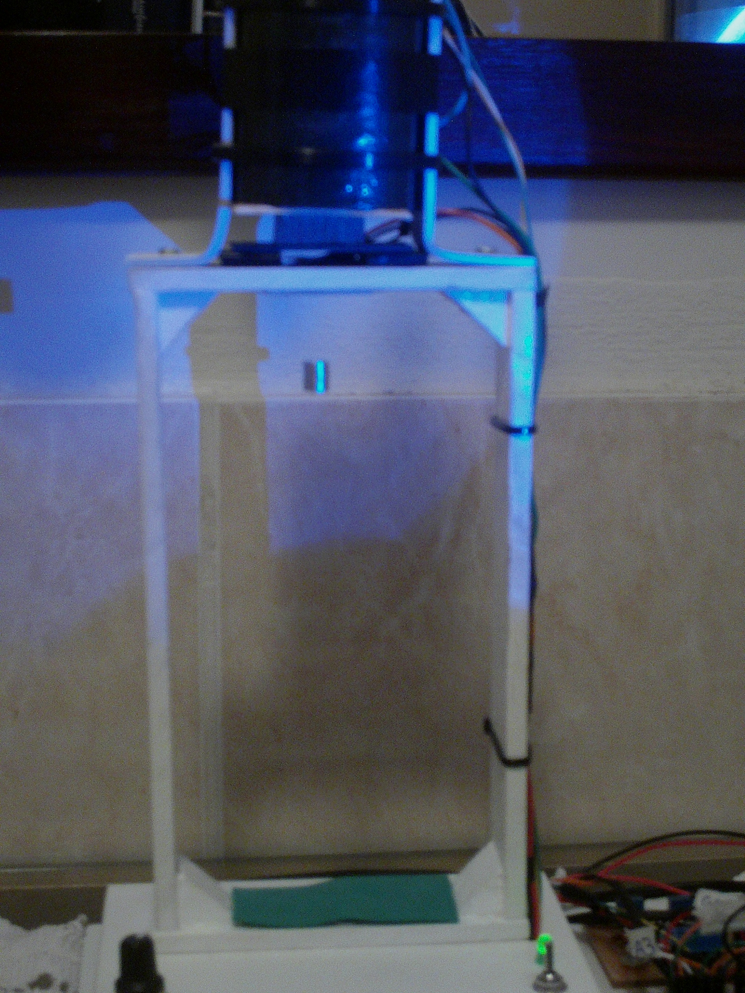
Magnetic Levitator II/Results/2.JPG
