felipecacique/MagneticLevitation/Magnetic Levitator II/Results/3.JPG

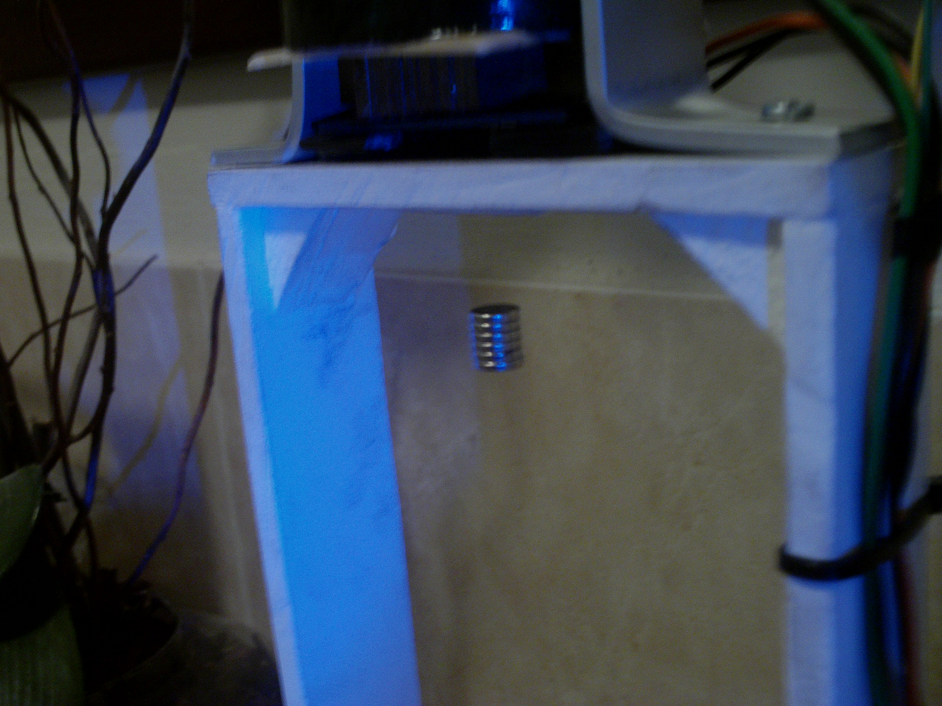
Magnetic Levitator II/Results/3.JPG
