felipecacique/MagneticLevitation/Magnetic Levitator II/Results/4.JPG

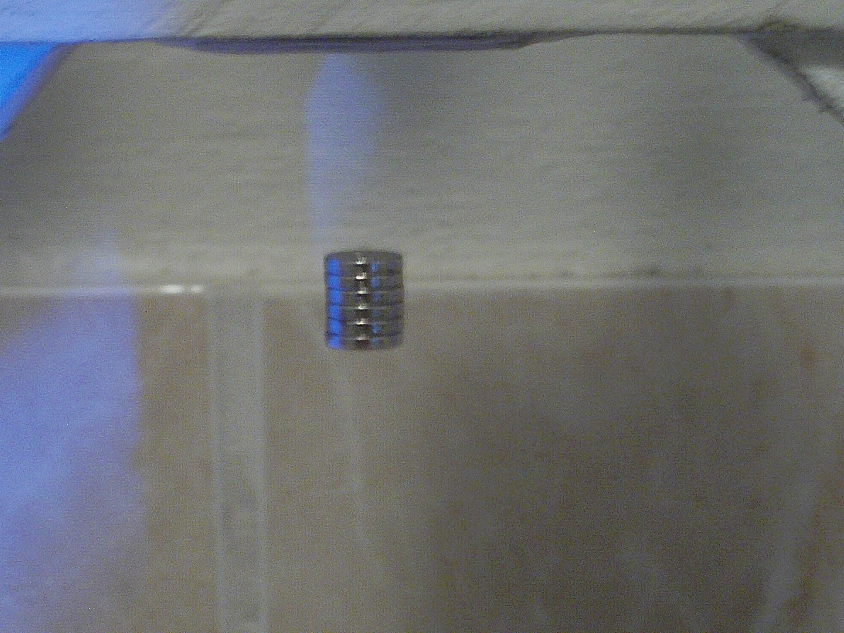
Magnetic Levitator II/Results/4.JPG
