felipecacique/MagneticLevitation/Magnetic Levitator II/Results/5.JPG

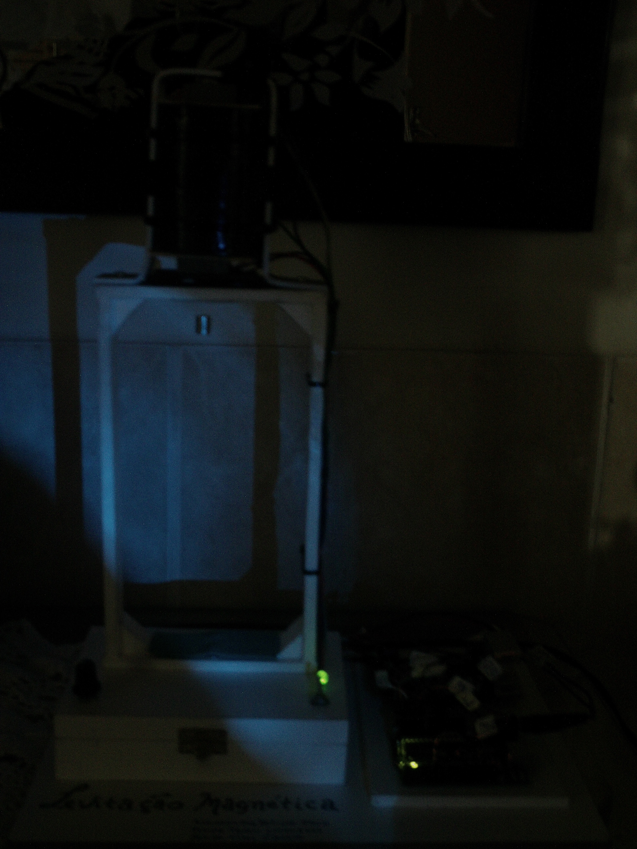
Magnetic Levitator II/Results/5.JPG
