felipecacique/MagneticLevitation/Magnetic Levitator II/Results/6.JPG

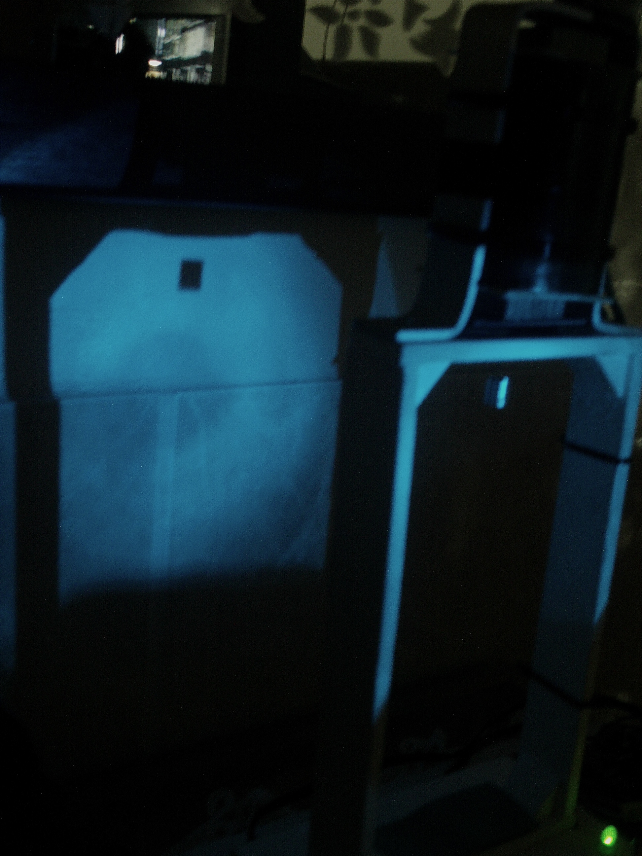
Magnetic Levitator II/Results/6.JPG
