felipecacique/MagneticLevitation/Others/componentes mirror.pdf

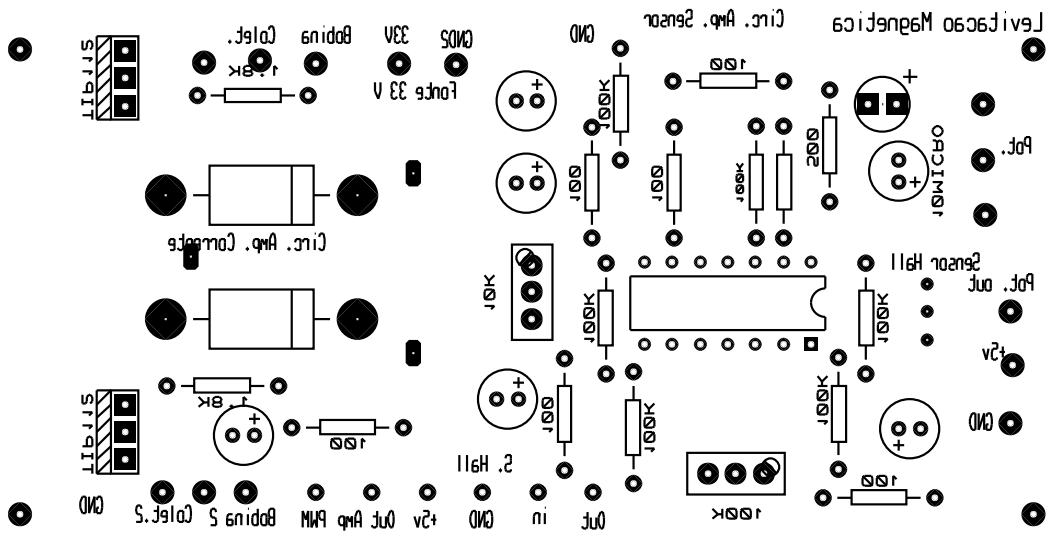
[picture p118: page 1]
