felipecacique/MagneticLevitation/Others/componentes.pdf

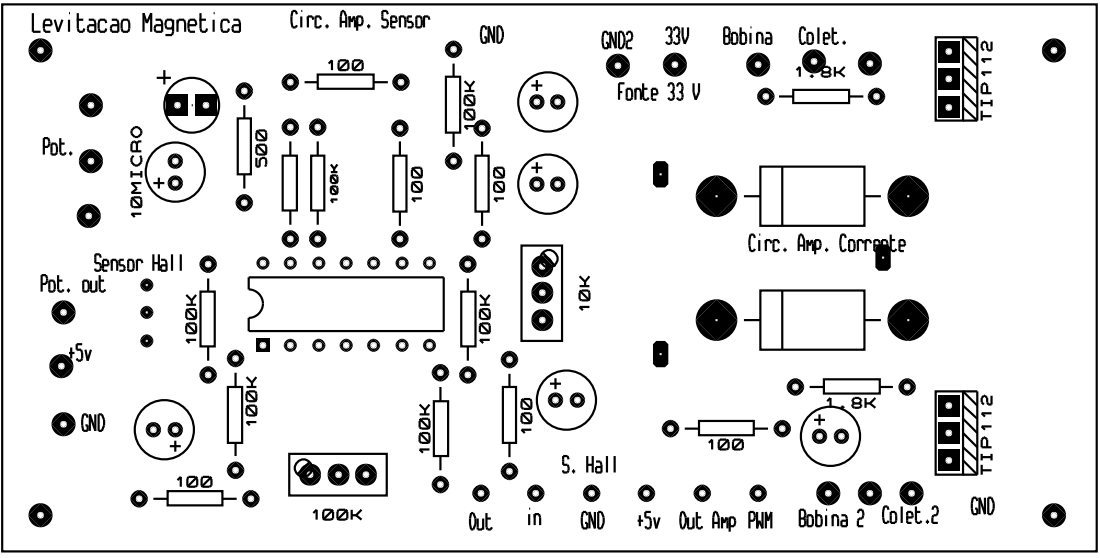
[picture p119: page 1]
