felipecacique/MagneticLevitation/Others/amp.pdf

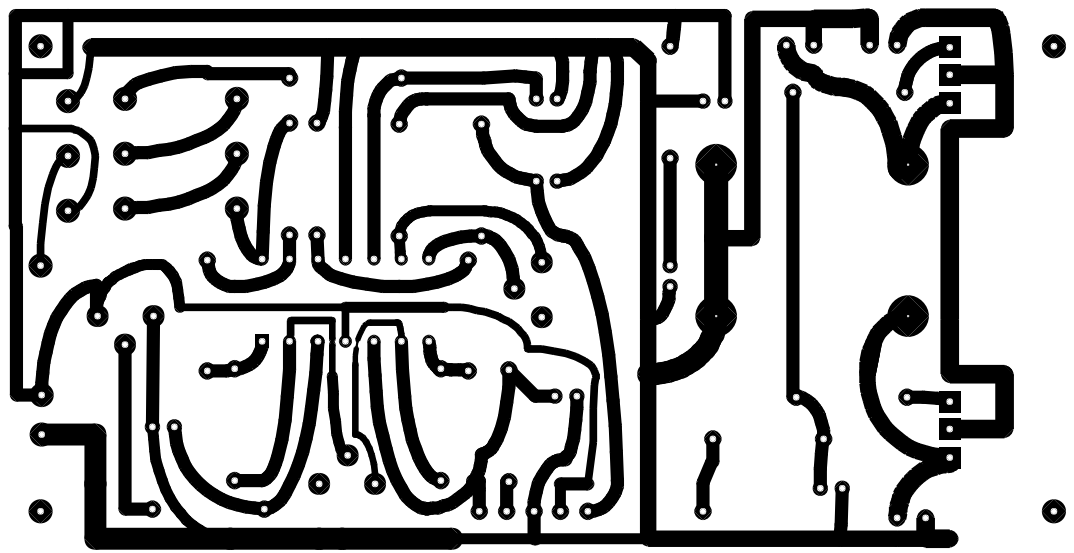
[picture p120: page 1]
