felipecacique/MagneticLevitation/Others/amplificador operacional 2 TIC.PDF

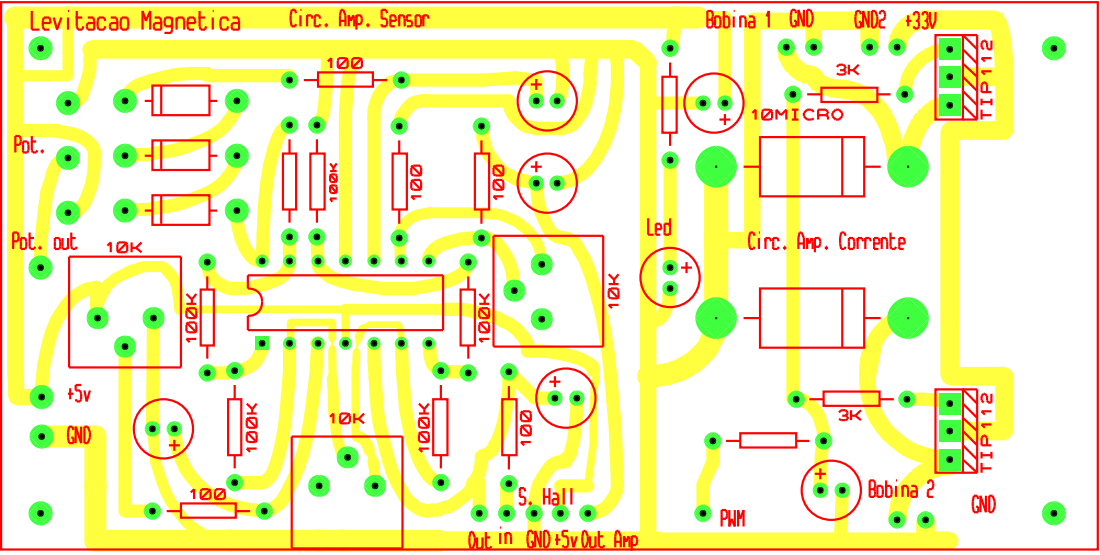
[picture p121: page 1]
