felipecacique/MagneticLevitation/Others/amplificador operacional 3 TIC.PDF

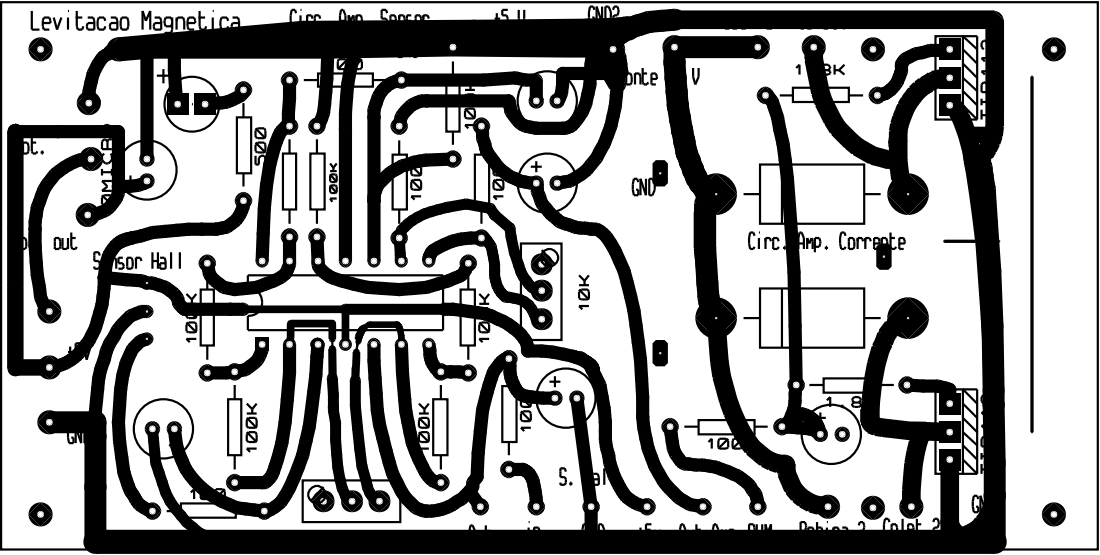
[picture p122: page 1]
