felipecacique/MagneticLevitation/Others/amplificador operacional pcb button.pdf

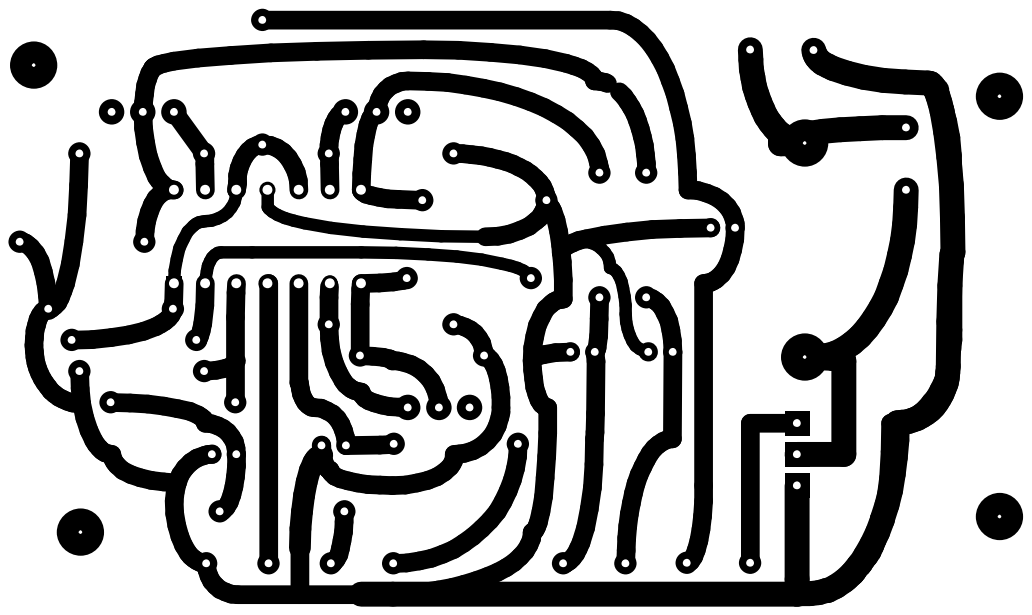
[picture p123: page 1]
