felipecacique/MagneticLevitation/Others/amplificador operacional pcb top silk.pdf

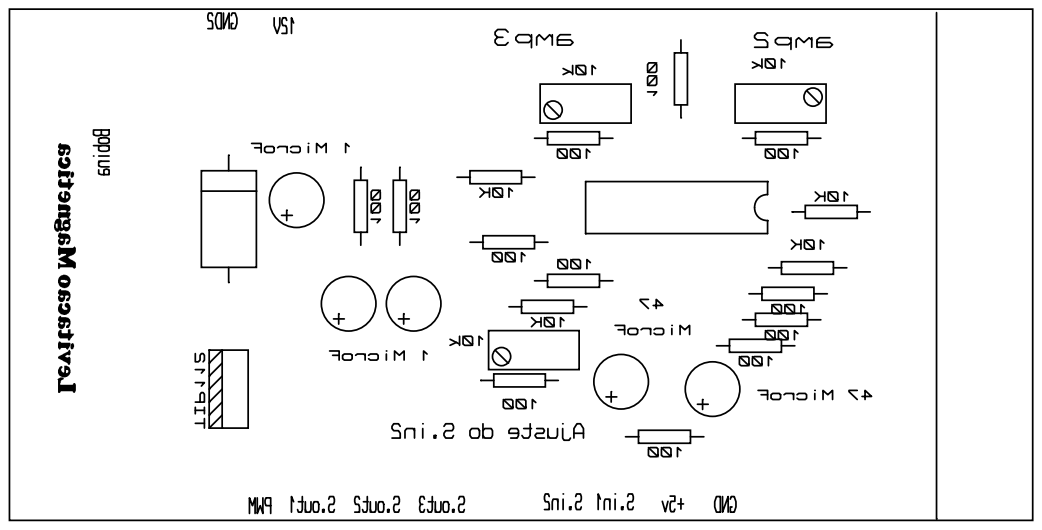
[picture p124: page 1]
