felipecacique/MagneticLevitation/Others/amplificador operacional TIC.PDF

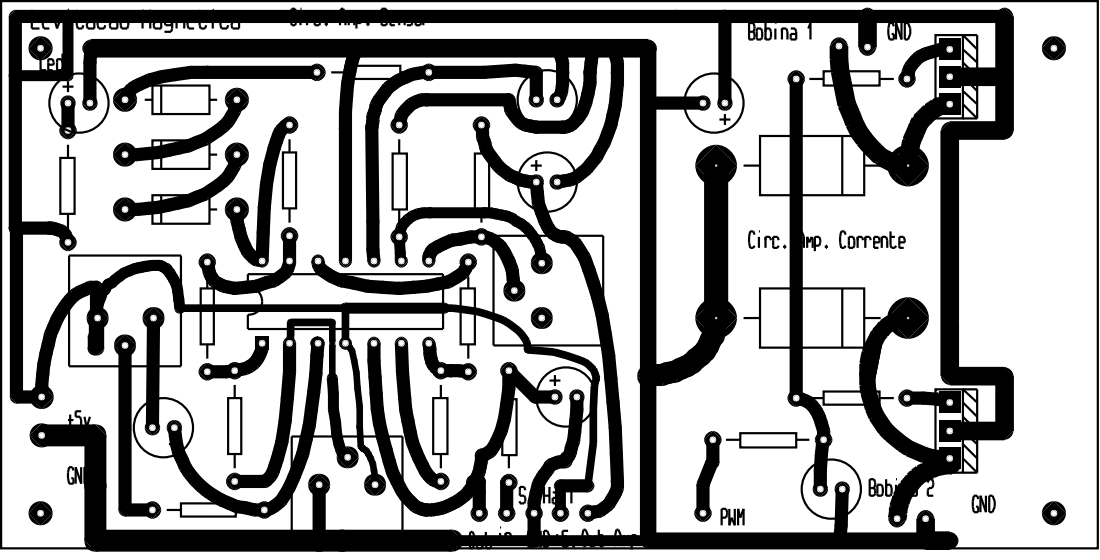
[picture p125: page 1]
