felipecacique/MagneticLevitation/Others/ao1 mirror.pdf

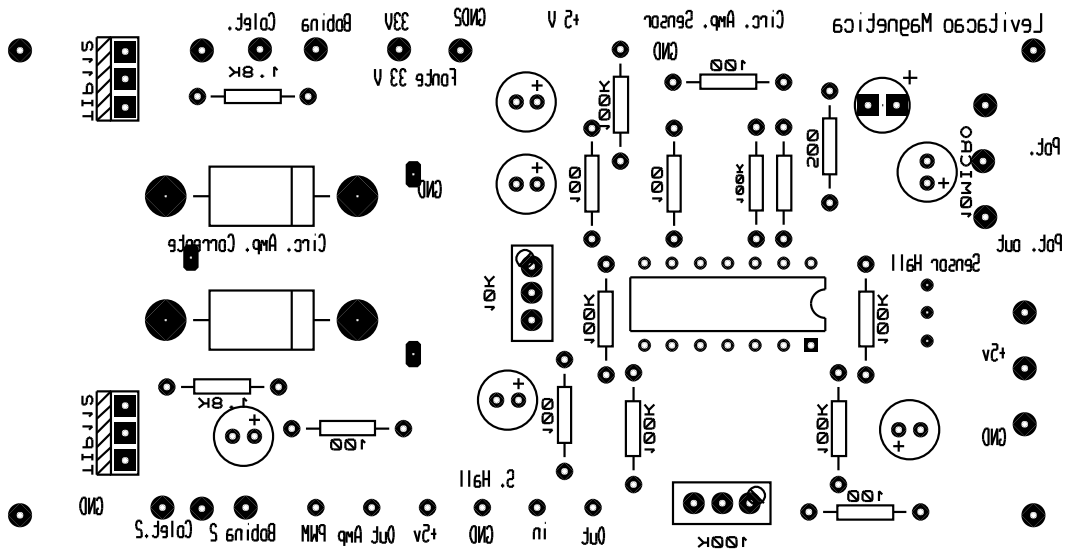
[picture p126: page 1]
