felipecacique/MagneticLevitation/Others/ao1.pdf

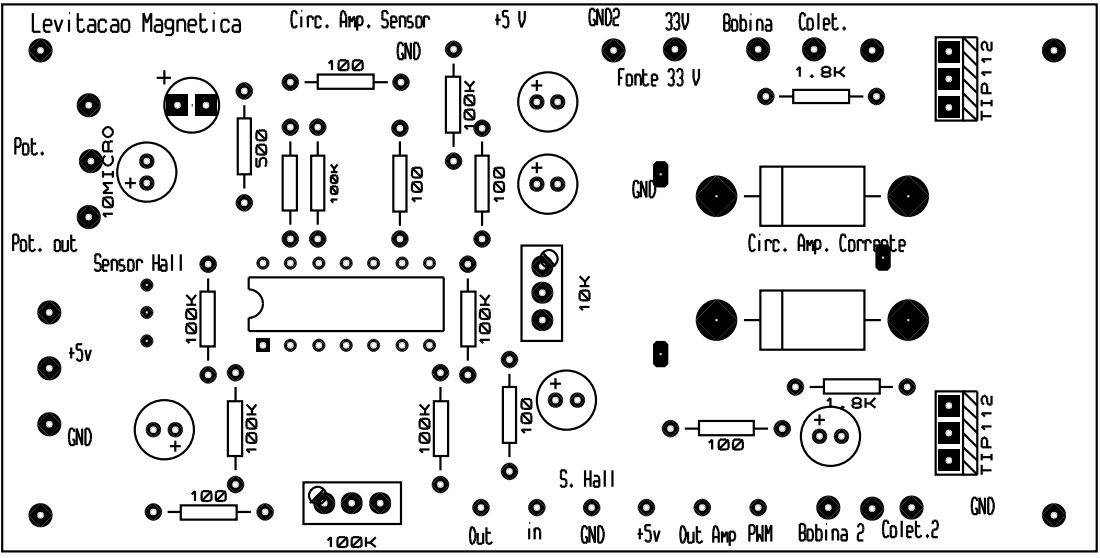
[picture p127: page 1]
