felipecacique/MagneticLevitation/Others/pcb mirror.pdf

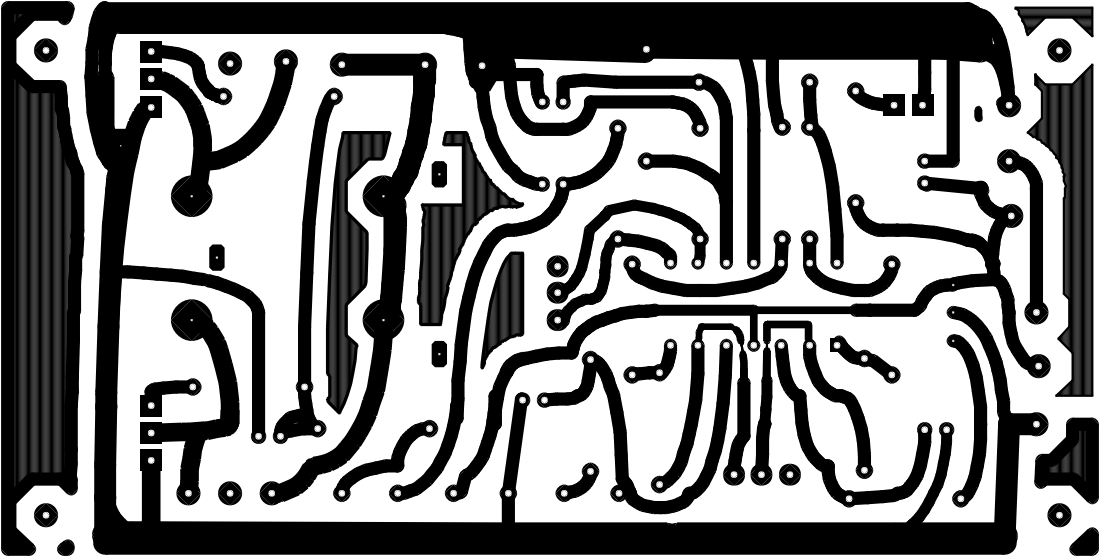
[picture p128: page 1]
