felipecacique/MagneticLevitation/Others/pcb-button.pdf

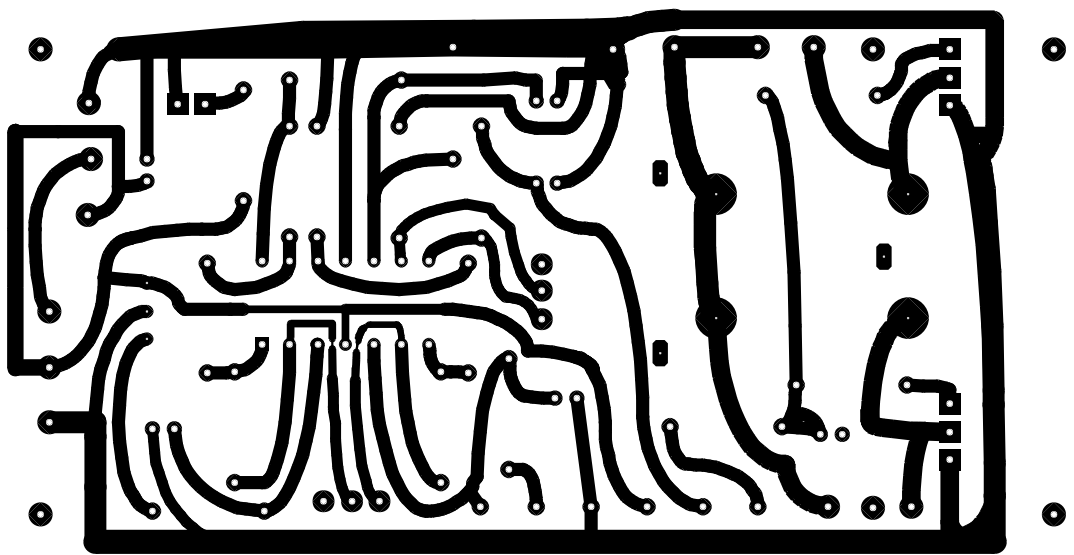
[picture p129: page 1]
