felipecacique/MagneticLevitation/Others/pcb-button2.pdf

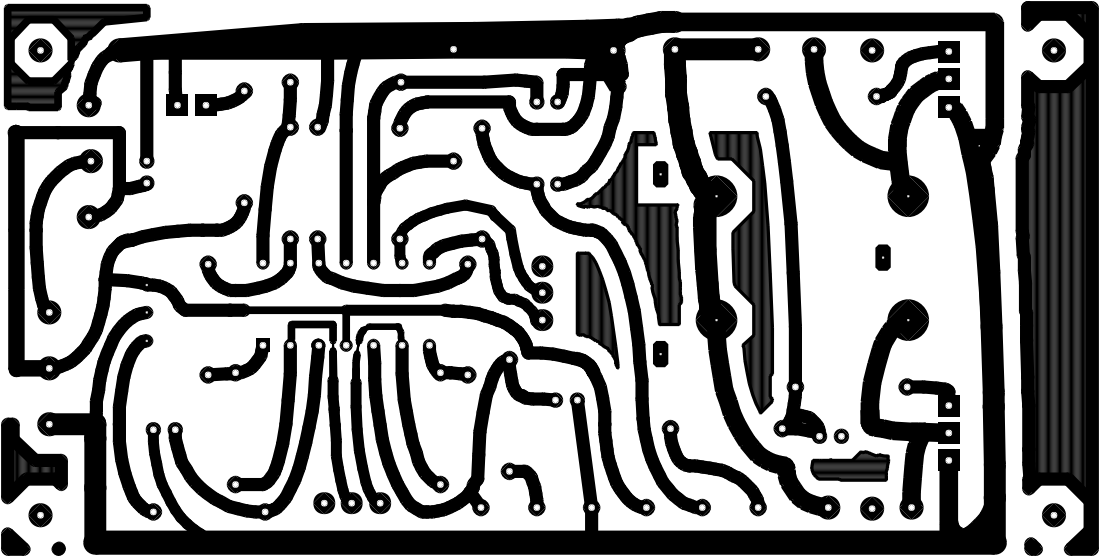
[picture p130: page 1]
