felipecacique/MagneticLevitation/Others/pcb.pdf

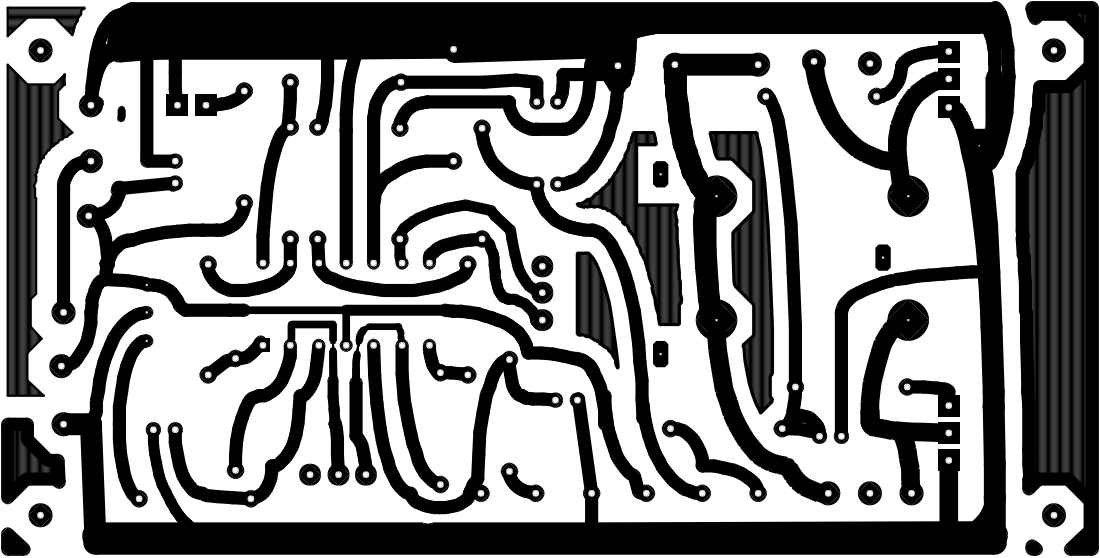
[picture p131: page 1]
