felipecacique/MagneticLevitation/(list of files, drawings)

Other design files:
Others/amplificador operacional pcb.LYT
Others/curva posicao x sensor hall.OPJ
